Ruizhi-Deng/ME350-Project/Mechanical/350 Design Library/Standard Parts/Bearings/外螺纹轴承参数-淘宝店家.jpg

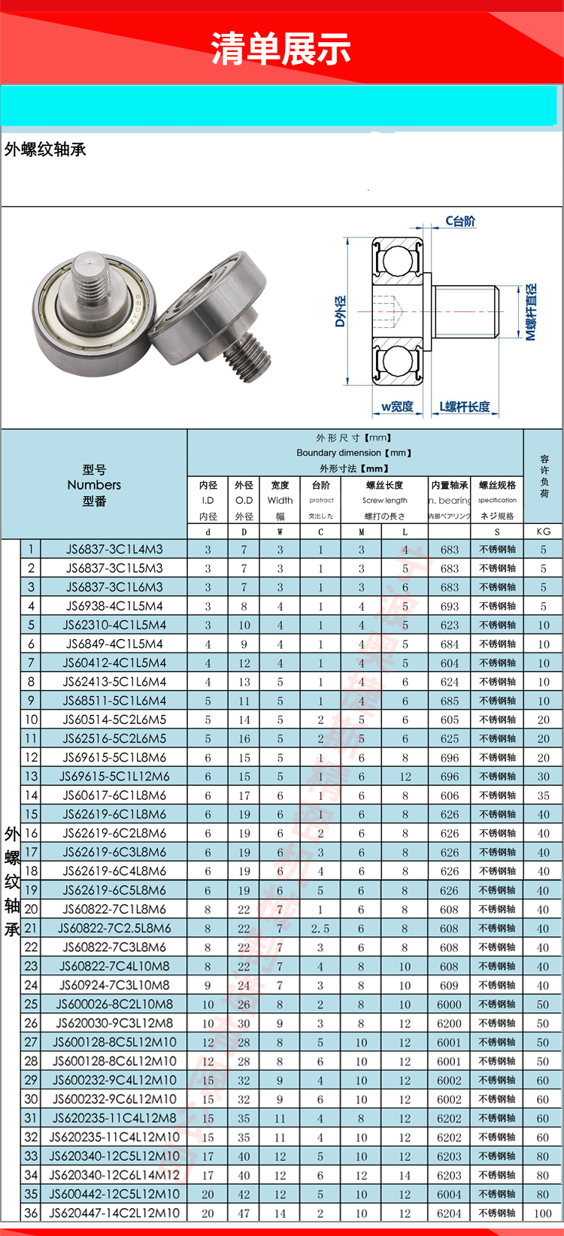
Mechanical/350 Design Library/Standard Parts/Bearings/外螺纹轴承参数-淘宝店家.jpg
