Ruizhi-Deng/ME350-Project/Mechanical/350 Design Library/Standard Parts/Nuts/Cold Pressing Nuts Parameter/071 072 073 Cold Pressing Nuts.jpg

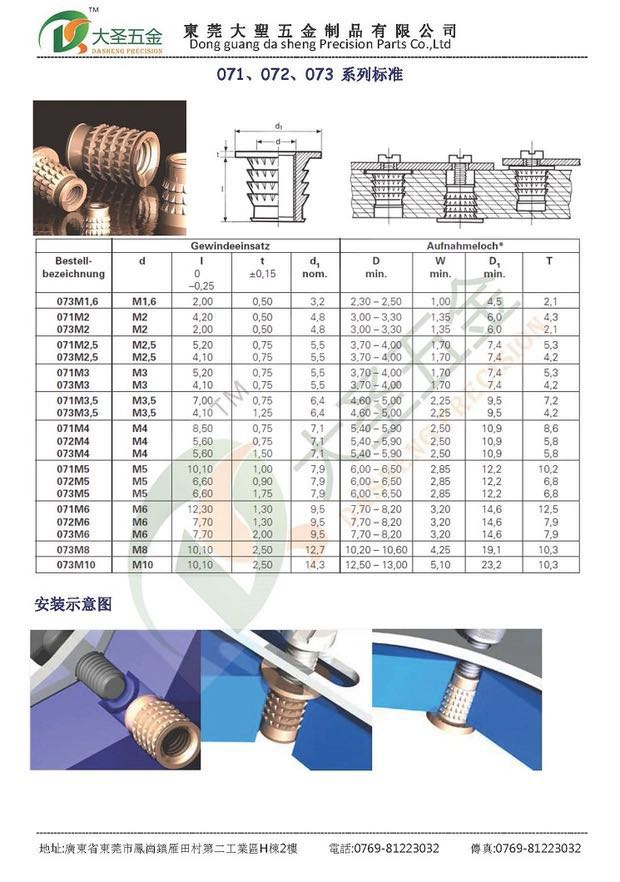
Mechanical/350 Design Library/Standard Parts/Nuts/Cold Pressing Nuts Parameter/071 072 073 Cold Pressing Nuts.jpg
