Ruizhi-Deng/ME350-Project/README.md

# ME350 Group 10 Project

This is the repository for the project of ME350 Group 10.
