Ruizhi-Deng/ME350-Project/Documents/dzfp_25362000000078212243_上海交通大学_20250804220630.pdf

# 电⼦发票（普通发票）

项目名称 | 规格型号 | 单 位 | 数 量 | 单 价 | 金 额 | 税率/征收率 | 税 额

发票号码：

开票日期：

购
买
方
信
息 | 统一社会信用代码/纳税人识别号：
名称： | 销
售
方
信
息 统一社会信用代码/纳税人识别号：

名称：

下载次数：1

合 | 计
价税合计（大写） | 肆拾柒圆柒角整 ¥ 47.70 （小写）

备 注

开票人：

国家税务总局 全 国 统一发 票 监 制章

江 西省税务局

¥47.23 | ¥0.47

张玉春

25362000000078212243

2025年08月04日

上海交通大学 | 江西善美邦纤维制品有限公司
1210000042500615X0 | 91360800332983584A
*专项化学用品*碳纤维管 12*10*1500mm | 支 | 47.2277227722772 | 47.23 | 1% | 0.47
