Ruizhi-Deng/ME350-Project/Documents/上海交通大学_4650637214420100312.pdf

销
售
方
信
息

统一社会信用代码/纳税人识别号：

购 名称：
买
方
信
息

统一社会信用代码/纳税人识别号：

名称：

25442000000448975464

2025年07月25日

上海交通大学

31010442500615X

广州市星翼电子科技有限公司

91440111598332340H

项目名称 | 规格型号 | 单 位 | 数 量 | 单 价 | 金 额 | 税率/征收率 | 税 | 额
*电子元件*烙铁 | T65智能电烙铁 | 套 | 1 154.194690265487 | 154.19 | 13% | 20.05
*电子元件*烙铁 | | | | | -10.62 | 13% | | -1.38
价税合计（大写） | 壹佰陆拾贰圆贰角肆分 （小写） ¥162.24
备 注 | 4650637214420100312
合 | 计

开票人：

吴国英

¥143.57 | ¥18.67
