Ruizhi-Deng/ME350-Project/Documents/dzfp_25362000000060566185_南昌县蒋巷欣兴塑料厂_20250623083155.pdf

# 电子发票（普通发票） 发票号码： 开票日期：

购
买
方
信
息

统一社会信用代码/纳税人识别号：

销
售
方
信
息

统一社会信用代码/纳税人识别号：

名称： | 名称：
项目名称 | 规格型号 | 单 位 | 数 量 | 单 价 | 金 额 | 税率/征收率 | 税 额
合 | 计
价税合计（大写） | 壹佰叁拾贰圆贰角整 ¥132.20 （小写）

备 注

开票人：

25362000000060566185

2025年06月22日

上海交通大学

1210000042500615X0

南昌县蒋巷欣兴塑料厂

## 92360121MABNWMTG8D

¥130.89 | ¥1.31

曾庆波

*塑料制品*塑料管PC透明
方管
10*10-10*15 | 件 | 6 21.8151815181518 | 130.89 | 1% | 1.31
