Ruizhi-Deng/ME350-Project/Documents/dzfp_25442000000369625213_惠州市煜盛电机科技有限公司_20250623150755.pdf

# 电子发票（普通发票） 发票号码： 开票日期：

购
买
方
信
息

统一社会信用代码/纳税人识别号：

销
售
方
信
息

统一社会信用代码/纳税人识别号：

名称： | 名称：
项目名称 | 规格型号 | 单 位 | 数 量 | 单 价 | 金 额 | 税率/征收率 | 税 额
合 | 计
价税合计（大写） | 捌拾柒圆贰角整 ¥87.20 （小写）

备 注

开票人：

25442000000369625213

2025年06月23日

上海交通大学

1210000042500615X0

惠州市煜盛电机科技有限公司

## 91441304MADAGW434E

¥86.34 | ¥0.86

钟云珠

*金属制品*马达 | JGY-370配支架 | 套 | 4 21.5841584158416 | 86.34 | 1% | 0.86
