Ruizhi-Deng/ME350-Project/Documents/dzfp_25952000000119703072.pdf

购
买
方
信
息

统一社会信用代码/纳税人识别号：

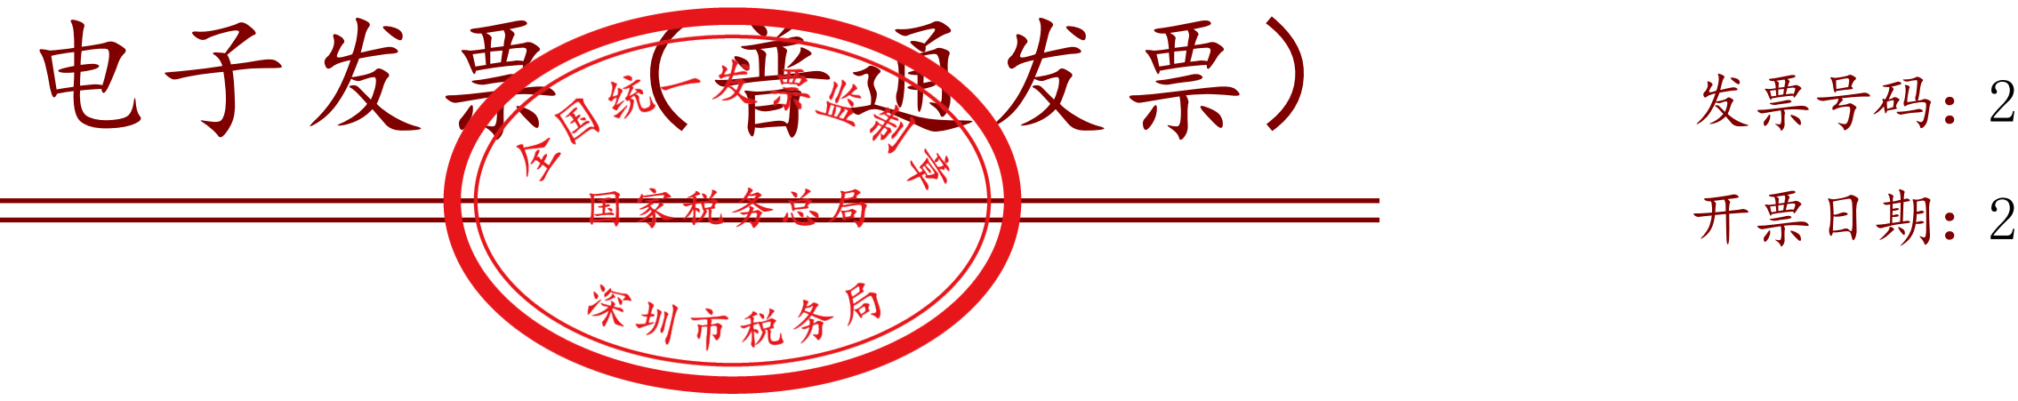
[picture p33: figure]
电子发票（普通发票）; 发票号码：; 开票日期：

销
售
方
信
息

统一社会信用代码/纳税人识别号：

名称： | 名称：
项目名称 | 规格型号 | 单 位 | 数 量 | 单 价 | 金 额 | 税率/征收率 | 税 额
合 | 计
价税合计（大写） | 贰拾叁圆捌角整 （小写） ¥23.80
备 注 | 订单：4385821140378100312 店铺：杰创森电子企业店

开票人：

下
载
次
数：1

25952000000119703072

2025年06月16日

上海交通大学

31010442500615X

深圳市杰创森科技有限公司

91440300MA5ECUMB6R

*电子元件*电子元器件 6mm加长 | 个 | 4 | 3.955 | 15.82 | 1% | 0.16
*齿轮*联轴器 | 6mm | 个 | 4 | 1.935 | 7.74 | 1% | 0.08
¥23.56 | ¥0.24

姜建平
