Ruizhi-Deng/ME350-Project/Documents/Render/corner.png

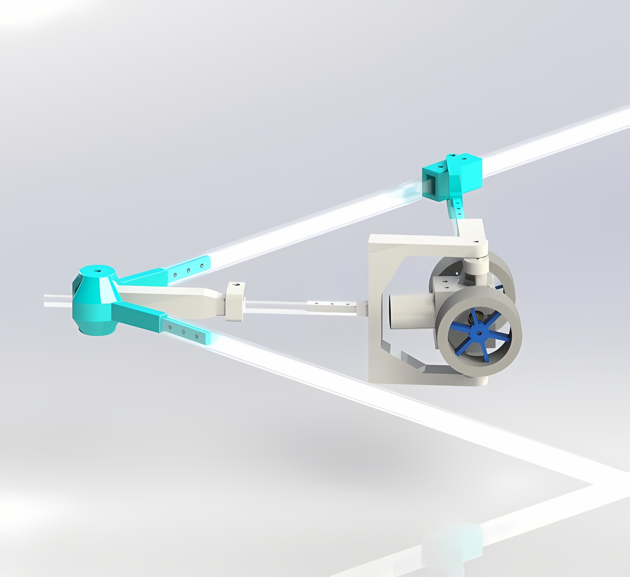
Documents/Render/corner.png
