Ruizhi-Deng/ME350-Project/Documents/Render/eds.JPG

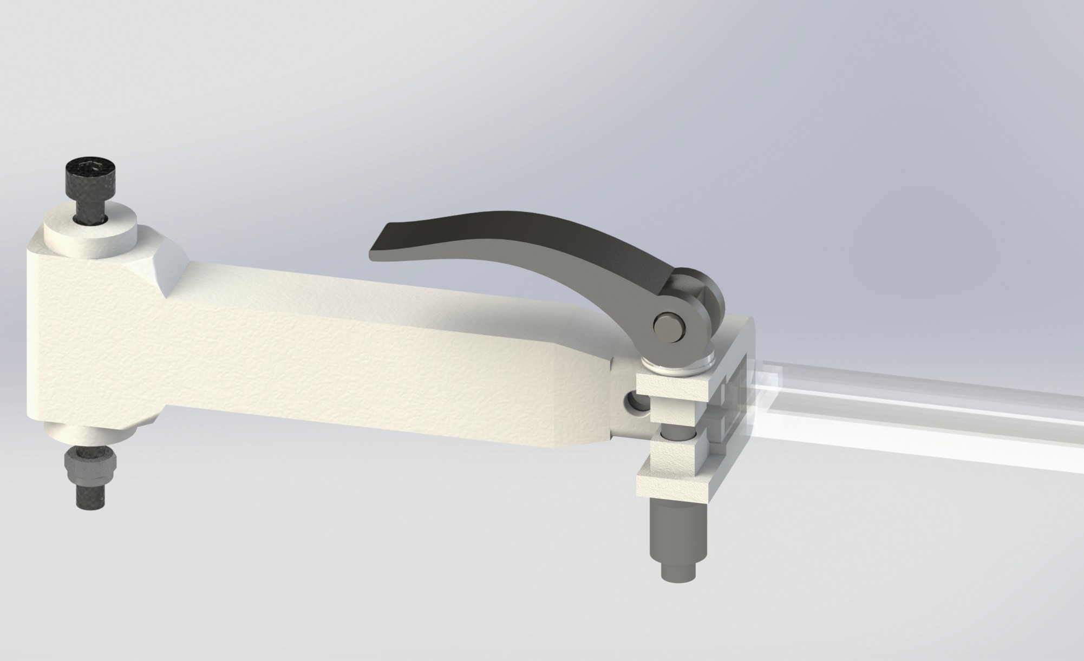
Documents/Render/eds.JPG
