Ruizhi-Deng/ME350-Project/Documents/Render/frame.JPG

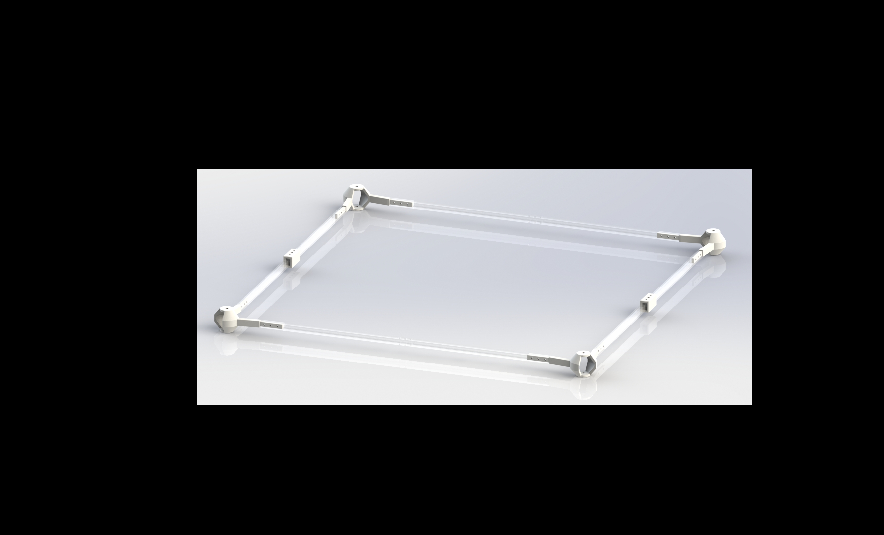
Documents/Render/frame.JPG
