Ruizhi-Deng/ME350-Project/Documents/Render/frame.png

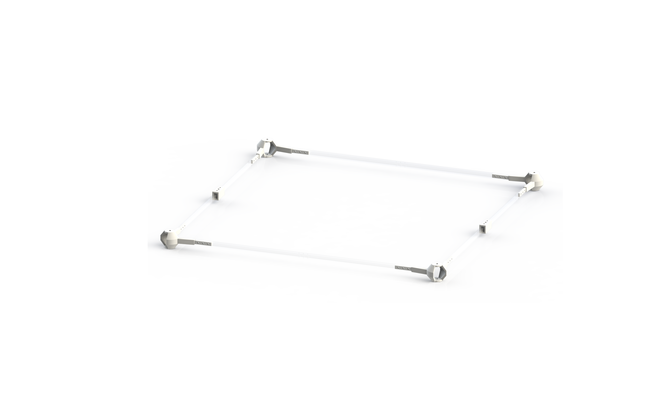
Documents/Render/frame.png
