Ruizhi-Deng/ME350-Project/Documents/Render/preview.png

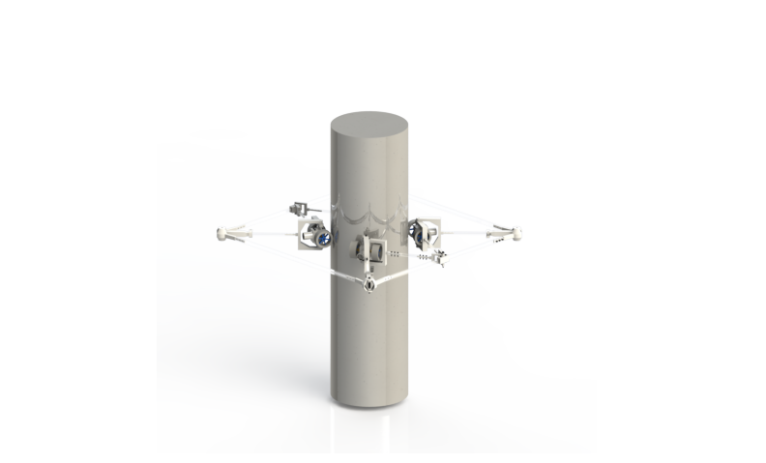
Documents/Render/preview.png
