Ruizhi-Deng/ME350-Project/Documents/Report/central base.png

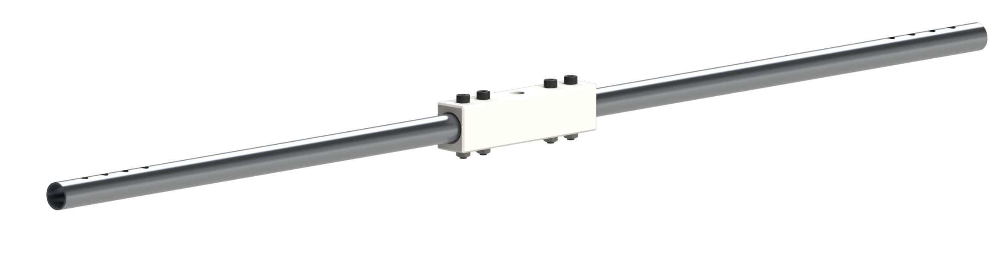
Documents/Report/central base.png
