Ruizhi-Deng/ME350-Project/Documents/Report/circuit.png

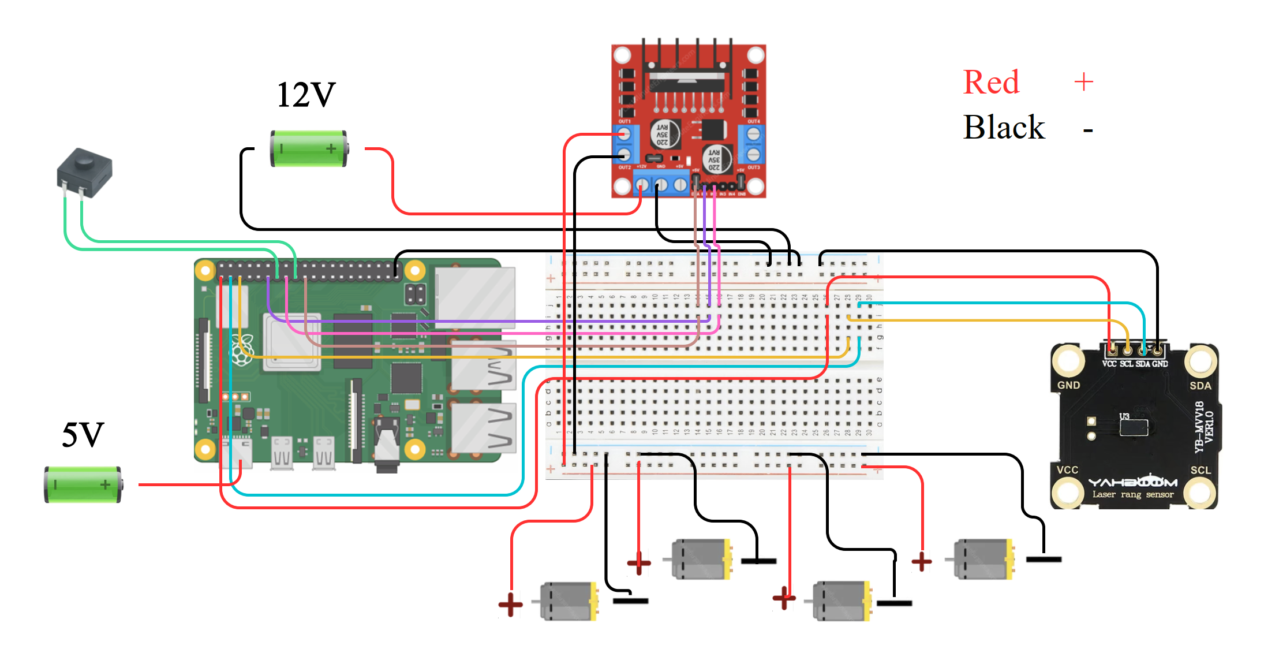
Documents/Report/circuit.png
