Ruizhi-Deng/ME350-Project/Documents/Report/clamp.png

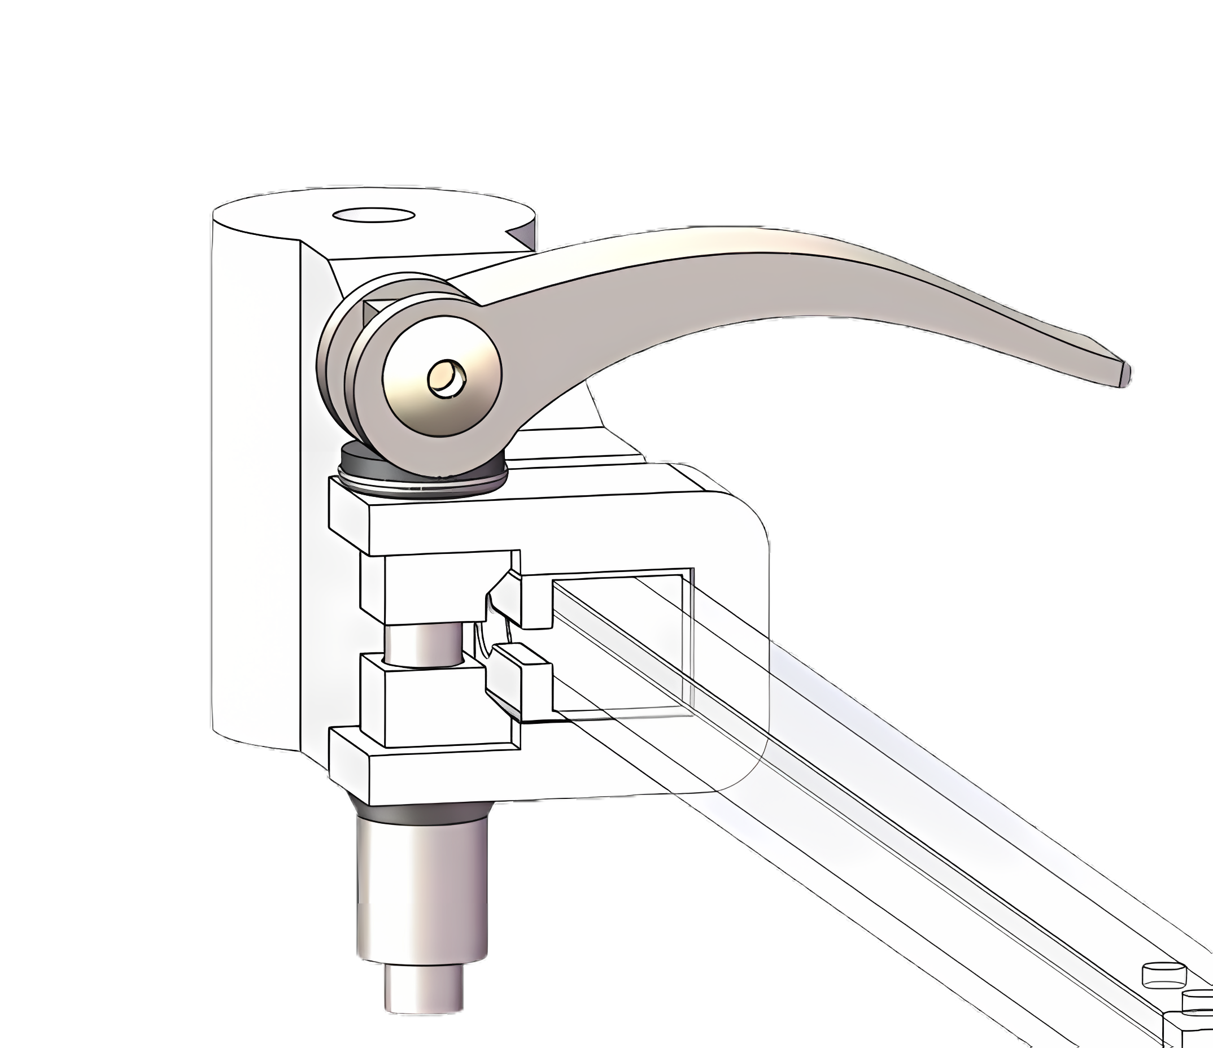
Documents/Report/clamp.png
