Ruizhi-Deng/ME350-Project/Documents/Report/corner connector set.png

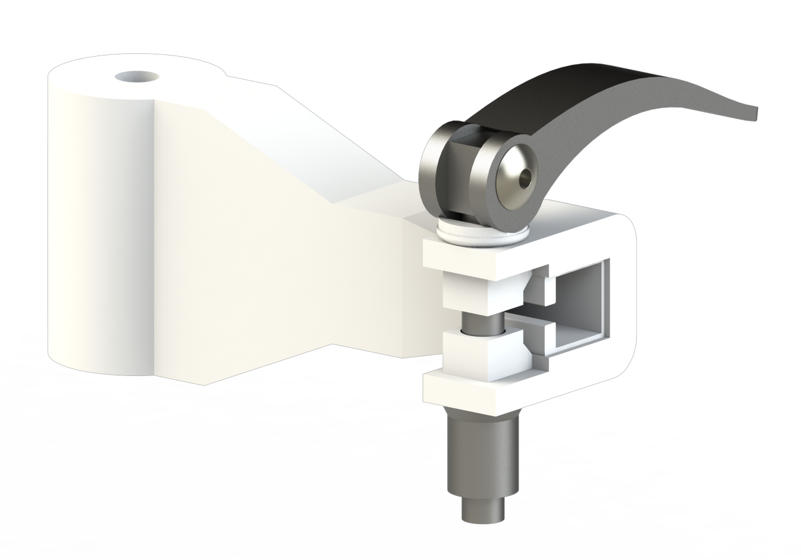
Documents/Report/corner connector set.png
