Ruizhi-Deng/ME350-Project/Documents/Report/corner.png

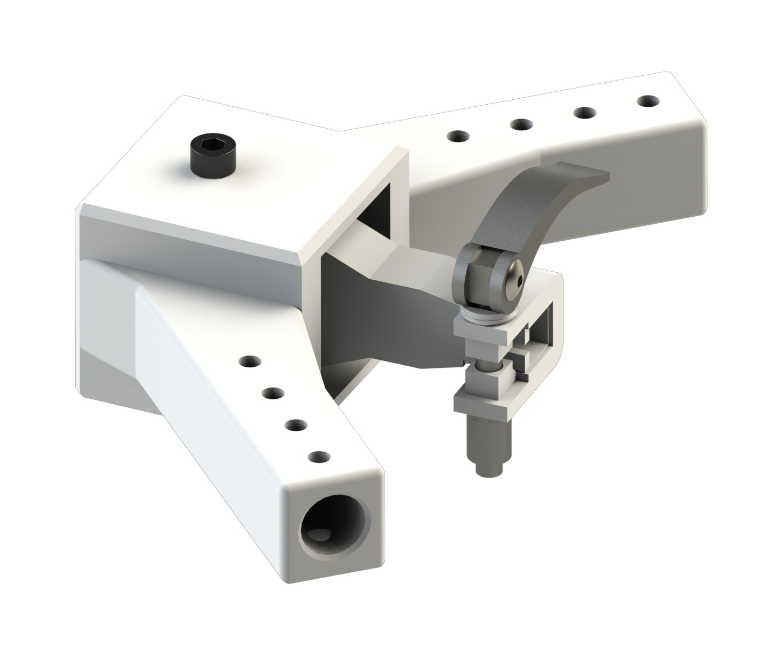
Documents/Report/corner.png
