Ruizhi-Deng/ME350-Project/Documents/Report/driving module motor 1.png

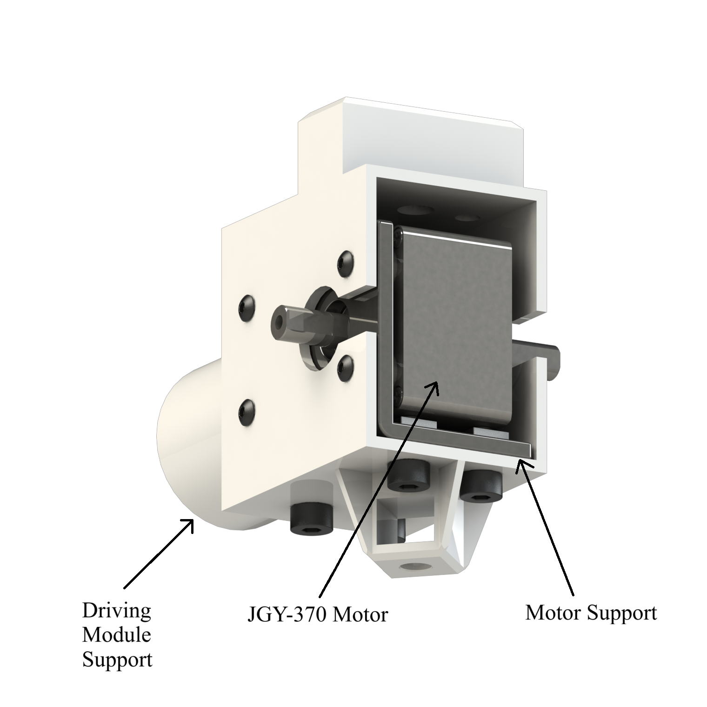
Documents/Report/driving module motor 1.png
