Ruizhi-Deng/ME350-Project/Documents/Report/driving module motor 2.png

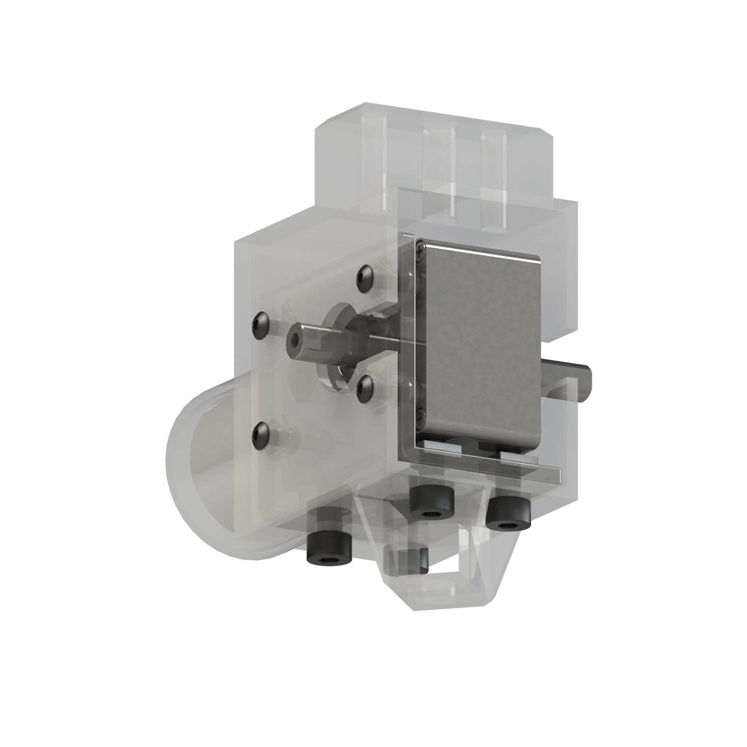
Documents/Report/driving module motor 2.png
