Ruizhi-Deng/ME350-Project/Documents/Report/driving module motor wheels 1.png

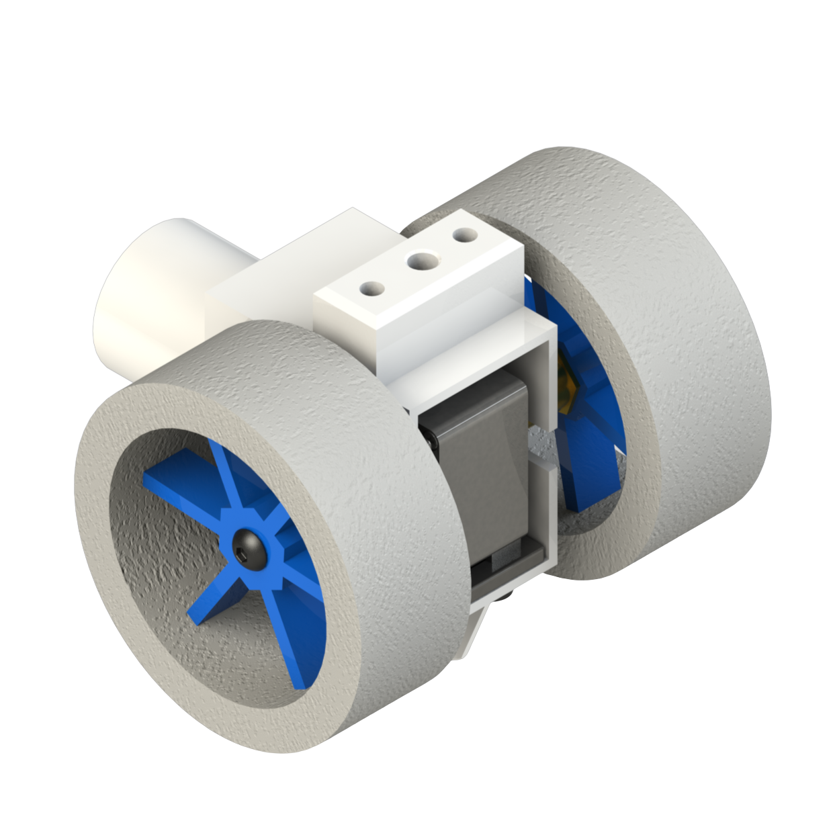
Documents/Report/driving module motor wheels 1.png
