Ruizhi-Deng/ME350-Project/Documents/Report/driving module total inner.png

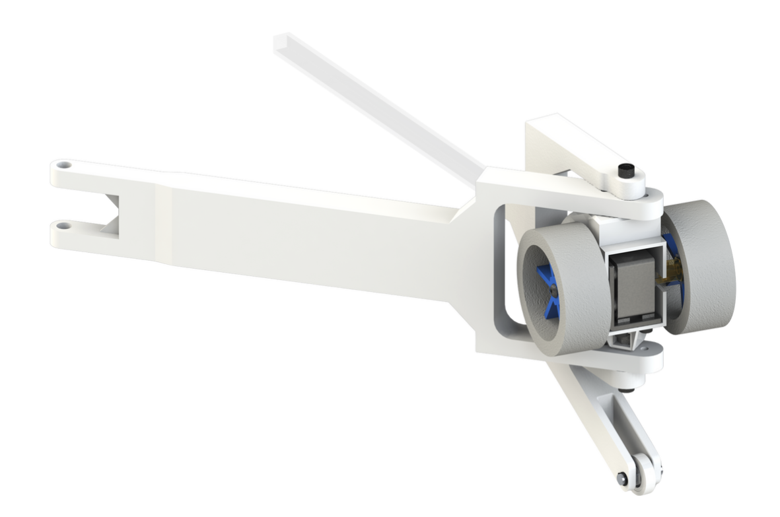
Documents/Report/driving module total inner.png
