Ruizhi-Deng/ME350-Project/Documents/Report/driving module total outer.png

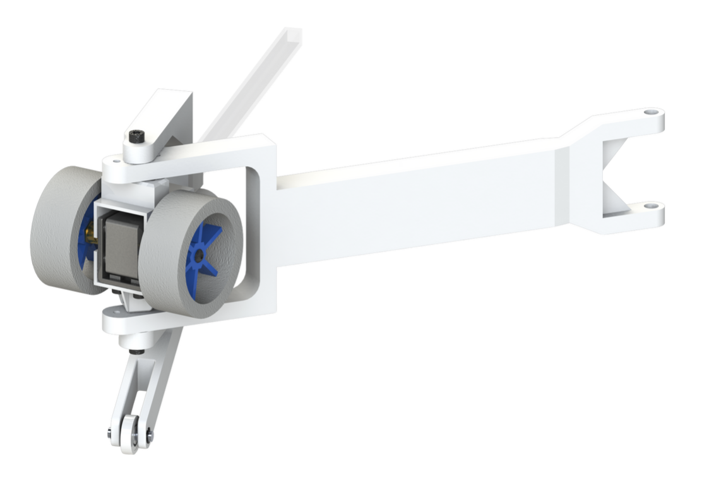
Documents/Report/driving module total outer.png
