Ruizhi-Deng/ME350-Project/Documents/Report/motor.png

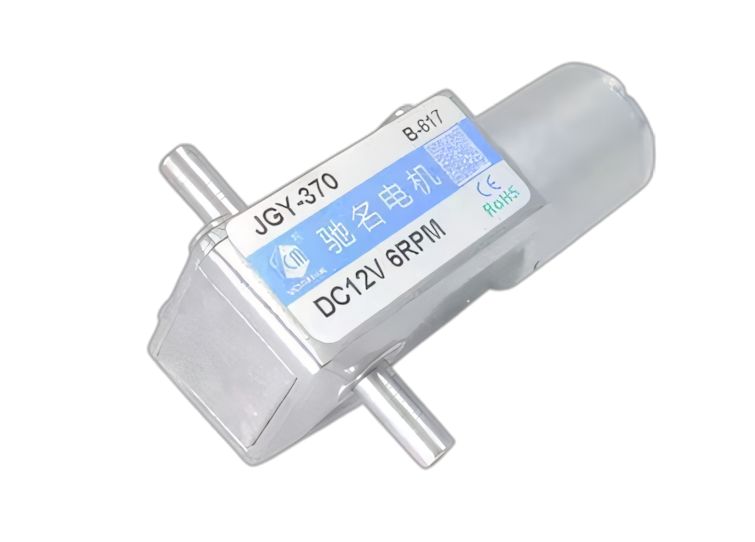
Documents/Report/motor.png
