Ruizhi-Deng/ME350-Project/Documents/Report/outer clamp front view.png

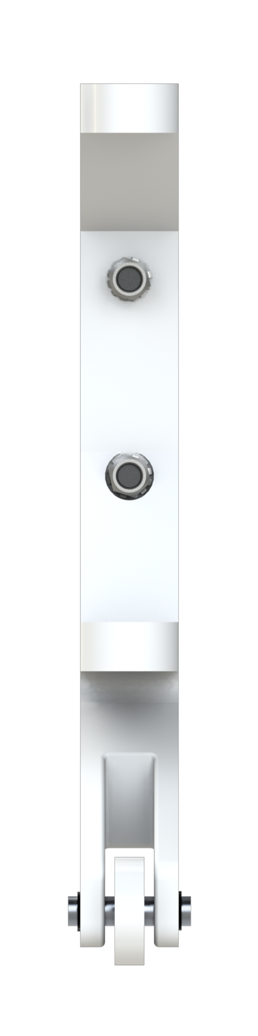
Documents/Report/outer clamp front view.png
