Ruizhi-Deng/ME350-Project/Documents/Report/outer clamp side view.png

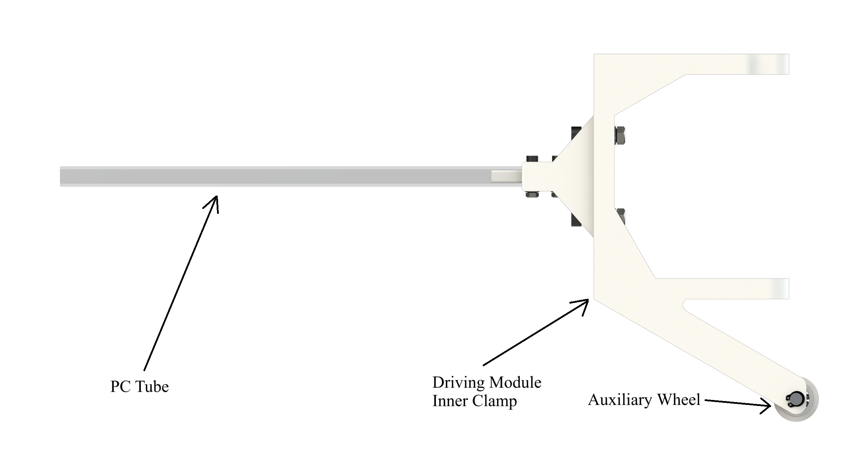
Documents/Report/outer clamp side view.png
