Ruizhi-Deng/ME350-Project/Documents/Report/total view 300.png

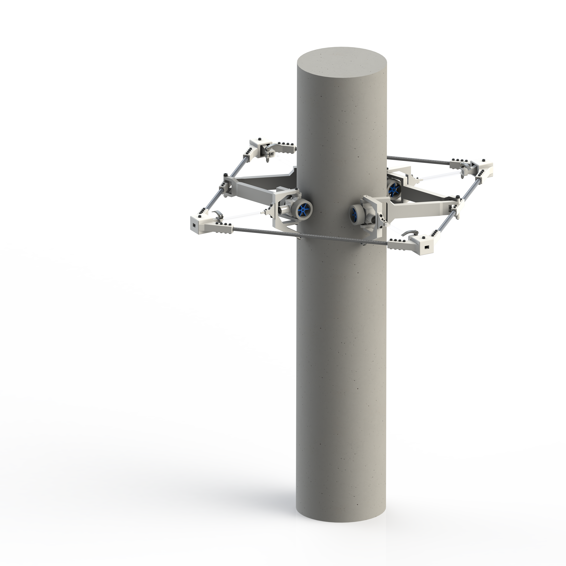
Documents/Report/total view 300.png
