Ruizhi-Deng/ME350-Project/Documents/Report/total view cropped small.png

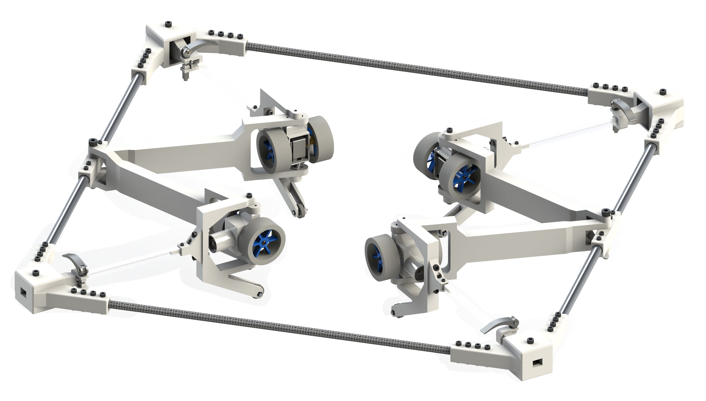
Documents/Report/total view cropped small.png
