Ruizhi-Deng/ME350-Project/Documents/Report/上视图600.png

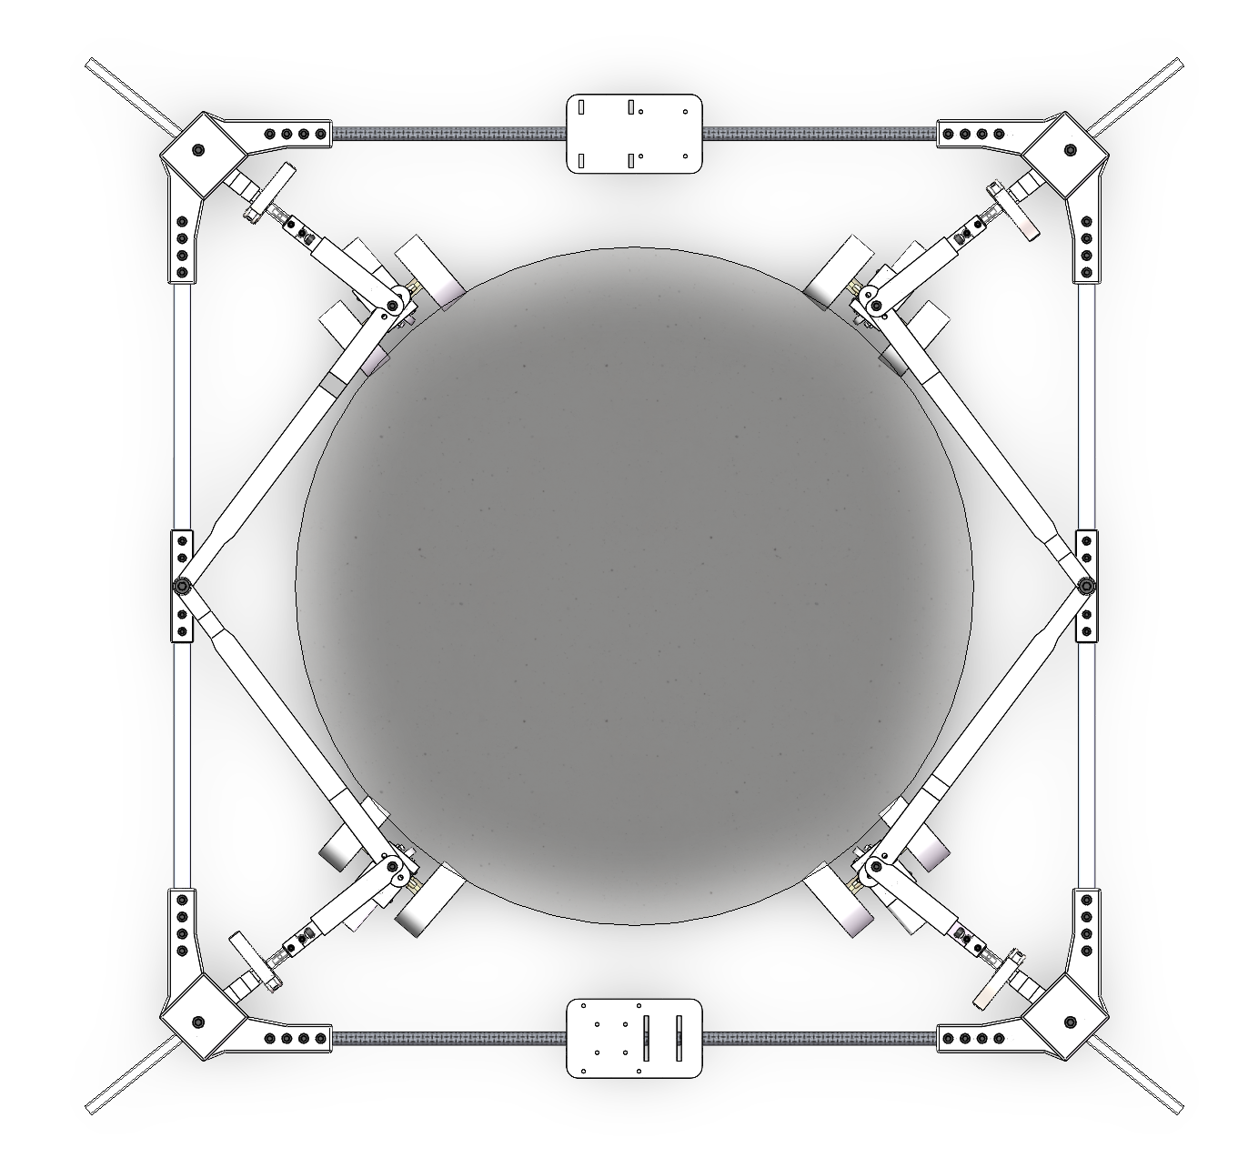
Documents/Report/上视图600.png
