Ruizhi-Deng/ME350-Project/Mechanical/350 Design Library/电机JGY 370/overview.jpg

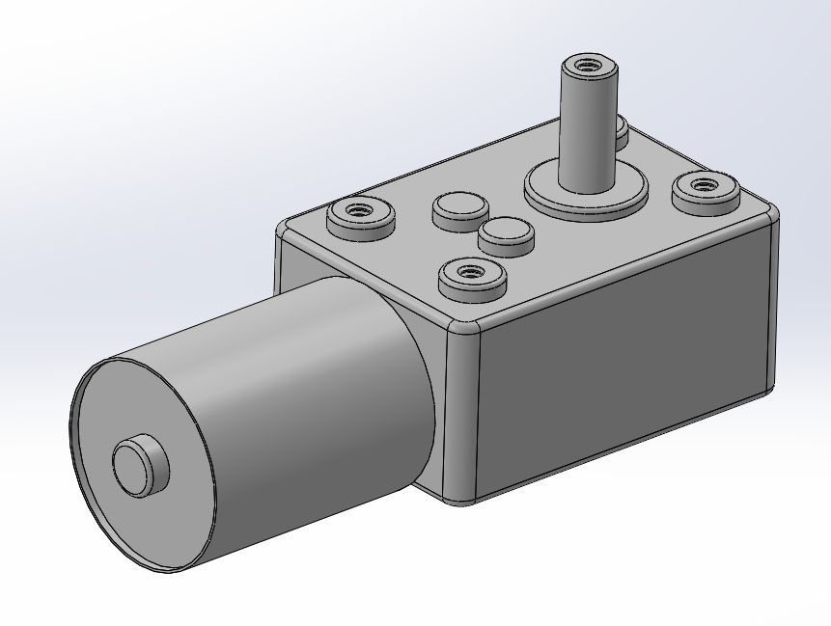
Mechanical/350 Design Library/电机JGY 370/overview.jpg
