Ruizhi-Deng/ME350-Project/Mechanical/350 Design Library/Standard Parts/Nuts/Cold Pressing Nuts Parameter/冷压螺母打印件孔尺寸.docx

001/002冷压螺母：

M2：2.9

M2.5：3.4

M3：3.9

M4：6.1

M5：6.7

M6：8.4

M8：10.8

0006冷压螺母：

M2：3.4

M2.5：4.3

M3：4.8

M4：6.3

M5：7.9

M6：9.8

M8：11.8

071/072/073冷压螺母：

M2：3.5

M2.5：4.2

M3：5.2

M4：6.1

M5：6.7

M6：8.4

M8：10.8

膨胀螺母：

M3：4.0放松效果强/嵌入难，4.1放松效果较强/嵌入简单

M4：5.6放松效果强/嵌入难，5.7放松效果较强/嵌入简单

M5：6.4放松效果强/嵌入难，6.5放松效果较强/嵌入简单

M6：8.0放松效果强/嵌入难，8.1放松效果较强/嵌入简单
