Ruizhi-Deng/ME350-Project/Mechanical/350 Design Library/Standard Parts/Nuts/Cold Pressing Nuts Parameter/001 002 Cold Pressing NUts.jpg

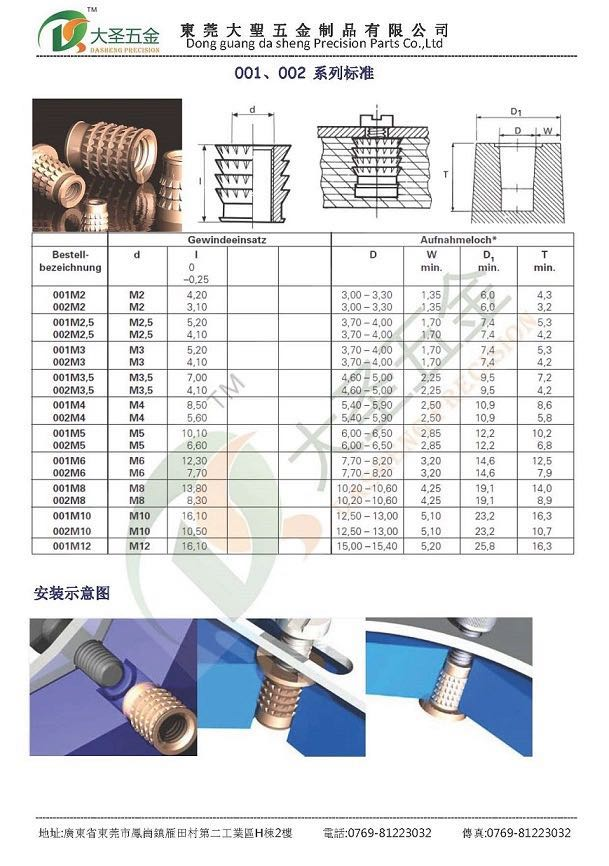
Mechanical/350 Design Library/Standard Parts/Nuts/Cold Pressing Nuts Parameter/001 002 Cold Pressing NUts.jpg
