Ruizhi-Deng/ME350-Project/Mechanical/350 Design Library/Standard Parts/Nuts/Cold Pressing Nuts Parameter/0006 Cold Pressing Nuts.jpg

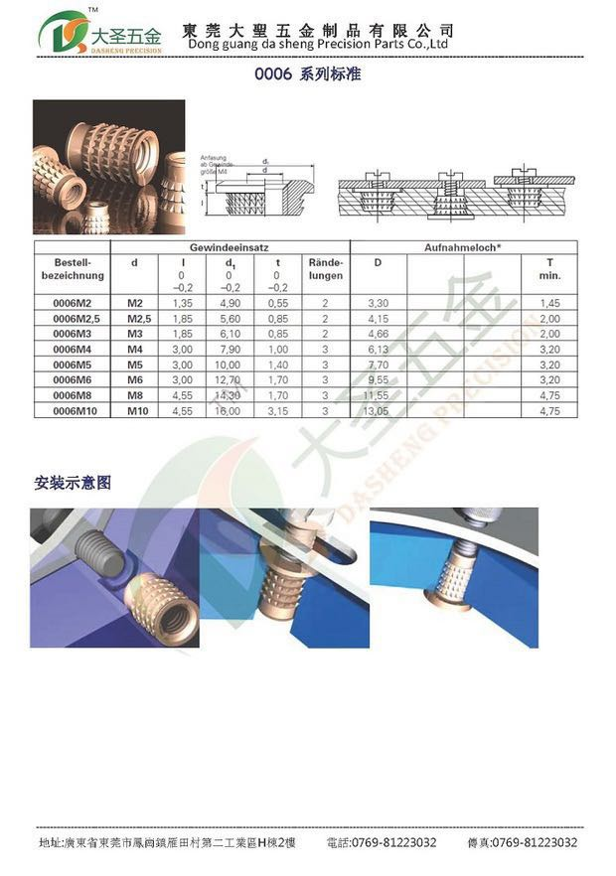
Mechanical/350 Design Library/Standard Parts/Nuts/Cold Pressing Nuts Parameter/0006 Cold Pressing Nuts.jpg
