Ruizhi-Deng/ME350-Project/Mechanical/350 Design Library/Standard Parts/Nuts/Cold Pressing Nuts Parameter/Slot Expension Nuts.jpg

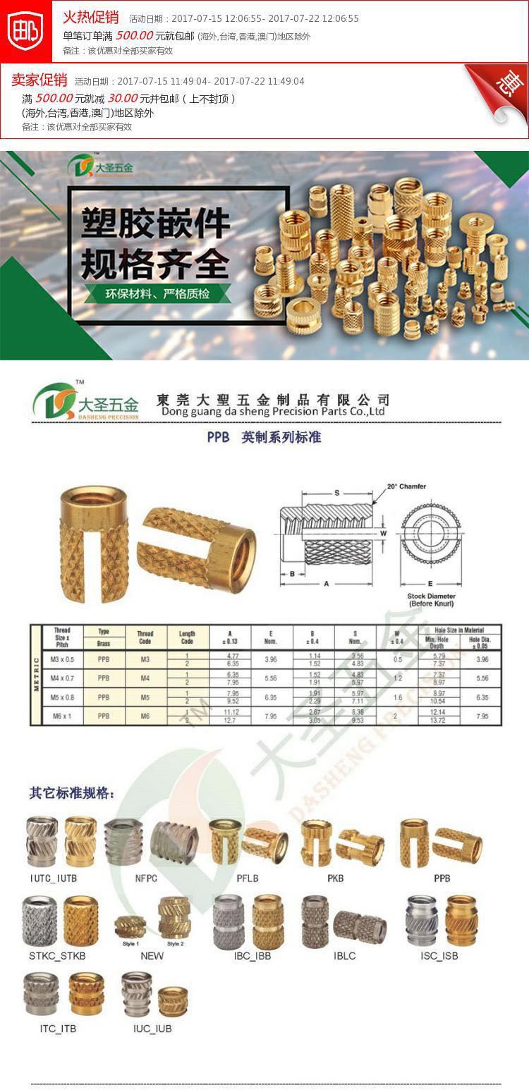
Mechanical/350 Design Library/Standard Parts/Nuts/Cold Pressing Nuts Parameter/Slot Expension Nuts.jpg
