Ruizhi-Deng/ME350-Project/Mechanical/350 Design Library/Standard Parts/Screws/螺丝参数/沉头螺丝参数.jpg

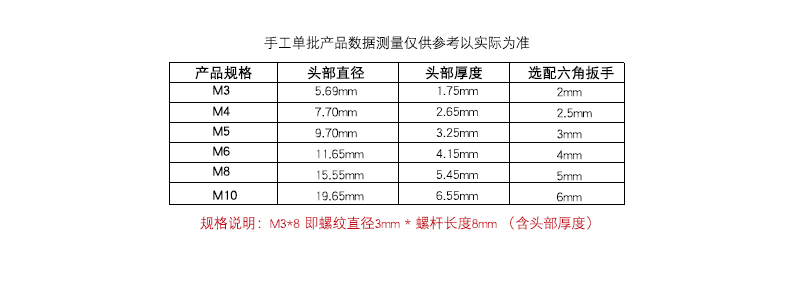
Mechanical/350 Design Library/Standard Parts/Screws/螺丝参数/沉头螺丝参数.jpg
