Ruizhi-Deng/ME350-Project/Mechanical/350 Design Library/Standard Parts/Screws/螺丝参数/英制塞打螺丝.jpg

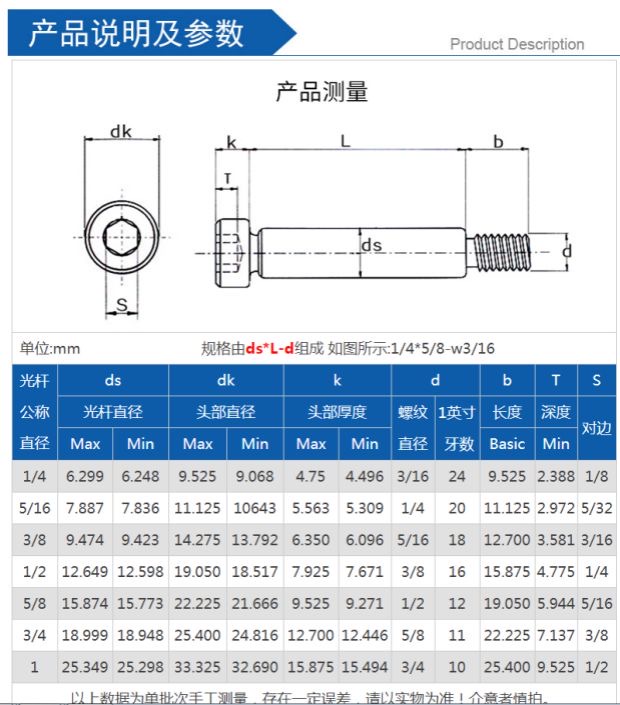
Mechanical/350 Design Library/Standard Parts/Screws/螺丝参数/英制塞打螺丝.jpg
