Ruizhi-Deng/ME350-Project/Mechanical/350 Design Library/Standard Parts/Springs/CFS25.png

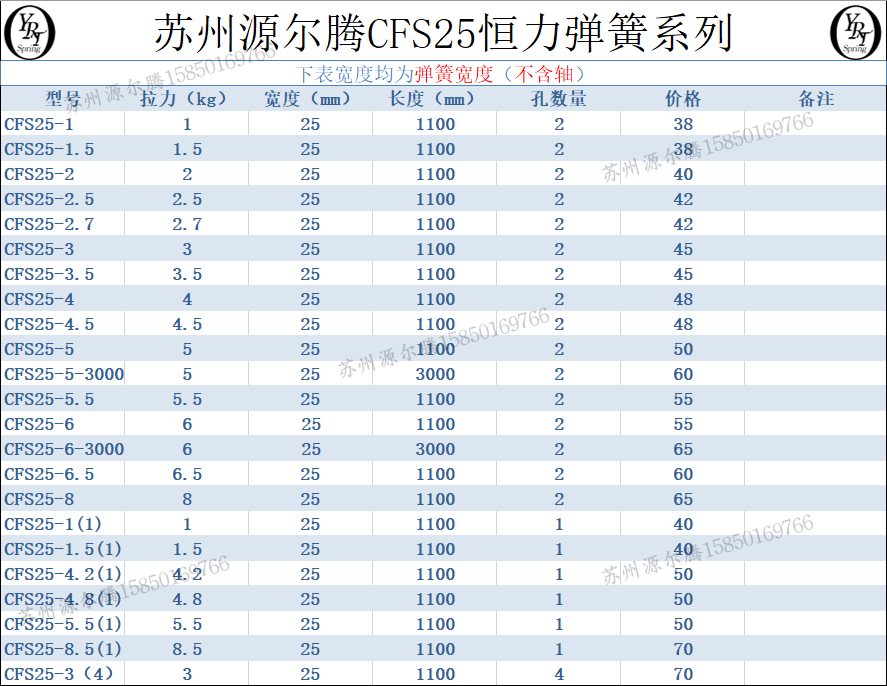
Mechanical/350 Design Library/Standard Parts/Springs/CFS25.png
