Ruizhi-Deng/ME350-Project/Mechanical/350 Design Library/Standard Parts/Springs/CFS.png

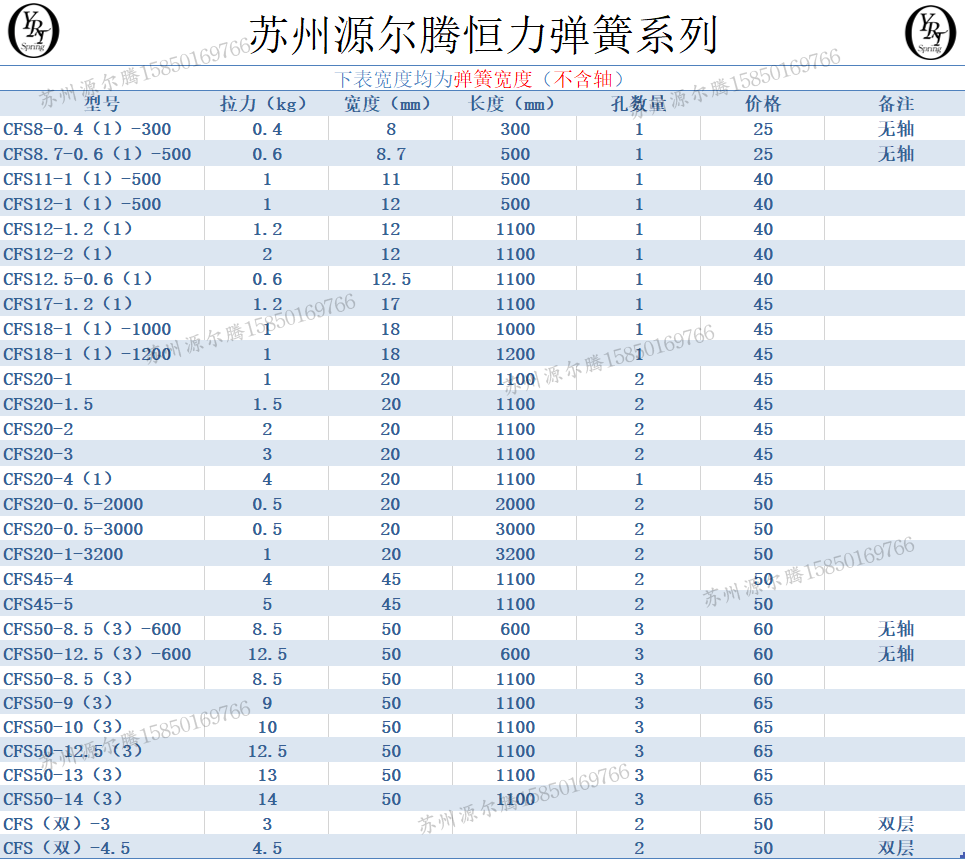
Mechanical/350 Design Library/Standard Parts/Springs/CFS.png
