Ruizhi-Deng/ME350-Project/Mechanical/350 Design Library/Standard Parts/铝方管规格图.jpg

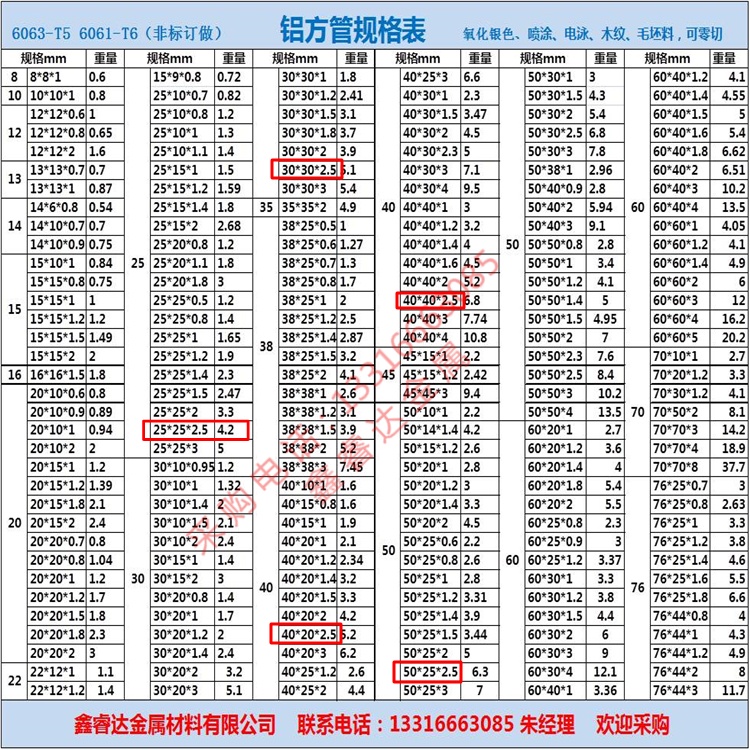
Mechanical/350 Design Library/Standard Parts/铝方管规格图.jpg
