Ruizhi-Deng/ME350-Project/Mechanical/Assembly/Assembly.SLDASM

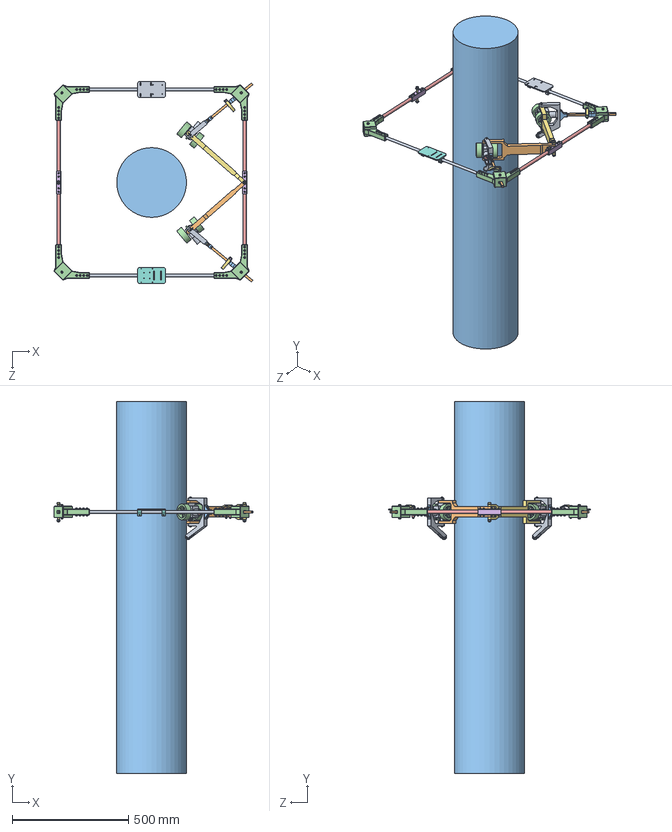
[picture p68: CAD file, 2025-08-08]
Mechanical/Assembly/Assembly.SLDASM
855.4 x 1600.0 x 870.0 mm
reference new
new frame corner connector base x 4
Al frame x 2
central connector base x 2
3-Cap Head Hexagon Screws-SJTUVEX x 70
3-K Shape Hexagon Nuts-SJTUVEX x 48
carbon fiber frame x 2
12mm to 15mm x 4
wheel x 4
六角联轴器6mm x 4
Double Output Axis JGY370 x 2
support x 2
single driver supportor x 2
3-Round Head Hexagon Screws-SJTUVEX x 12
3-Square Shape Nuts-SJTUVEX x 8
single driver connector outer x 2
PC_short_support x 2
frame corner connector x 2
frame corner connector pc clamp x 2
3-Nylon Hexagon Nuts-SJTUVEX x 10
nut x 2
shaft x 2
handle x 2
3-Aluminum Pop Rivet-SJTUVEX x 2
spacer x 2
central_inner-driver_inner connector
single driver connector outer casing x 2
Auxiliary wheel x 2
Auxiliary wheel shaft x 2
3-Shaft Circlip Rings-SJTUVEX x 4
central_outer-driver_inner connector
3-Plain Washers-SJTUVEX x 2
