Ruizhi-Deng/ME350-Project/Mechanical/Assembly/drive set central outer.SLDASM

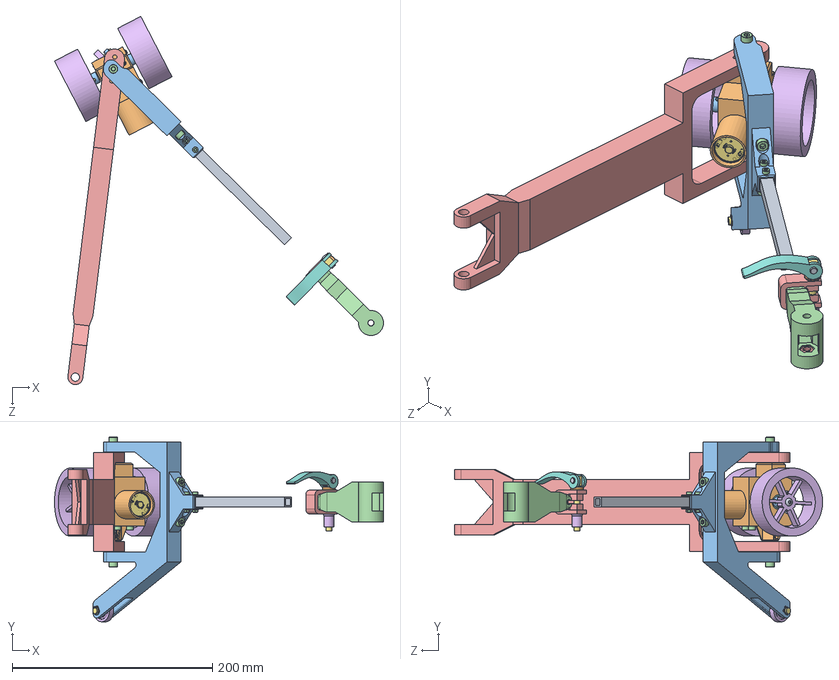
[picture p69: CAD file, 2025-08-08]
Mechanical/Assembly/drive set central outer.SLDASM
328.4 x 184.3 x 367.6 mm
3-Cap Head Hexagon Screws-SJTUVEX x 10
3-Nylon Hexagon Nuts-SJTUVEX x 4
wheel x 2
六角联轴器6mm x 2
Double Output Axis JGY370
support
single driver supportor
3-Round Head Hexagon Screws-SJTUVEX x 6
3-Square Shape Nuts-SJTUVEX x 4
single driver connector outer
PC_short_support
frame corner connector
frame corner connector pc clamp
nut
shaft
handle
3-Aluminum Pop Rivet-SJTUVEX
spacer
single driver connector outer casing
3-K Shape Hexagon Nuts-SJTUVEX x 4
central_outer-driver_inner connector
Auxiliary wheel
Auxiliary wheel shaft
3-Shaft Circlip Rings-SJTUVEX x 2
