Ruizhi-Deng/ME350-Project/Mechanical/drive set central outer.SLDASM

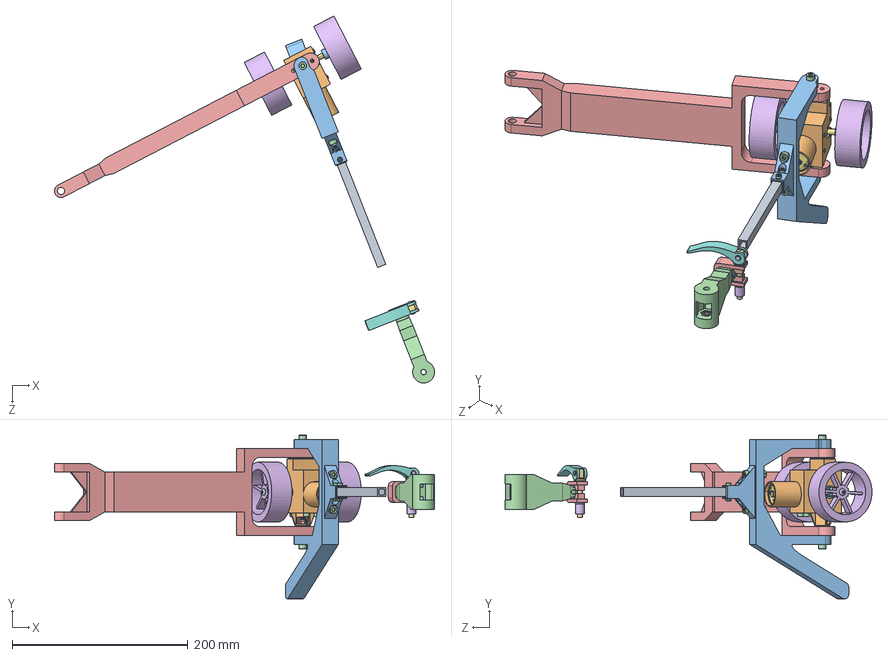
[picture p70: CAD file, 2025-07-29]
Mechanical/drive set central outer.SLDASM
432.8 x 186.4 x 417.9 mm
3-Cap Head Hexagon Screws-SJTUVEX x 10
3-Nylon Hexagon Nuts-SJTUVEX x 4
wheel x 2
六角联轴器6mm x 2
Double Output Axis JGY370
support
single driver supportor
3-Round Head Hexagon Screws-SJTUVEX x 6
3-Square Shape Nuts-SJTUVEX x 4
single driver connector outer
PC_short_support
frame corner connector
frame corner connector pc clamp
nut
shaft
handle
3-Aluminum Pop Rivet-SJTUVEX
spacer
single driver connector outer casing
3-K Shape Hexagon Nuts-SJTUVEX x 4
central_outer-driver_inner connector
