Ruizhi-Deng/ME350-Project/Mechanical/Assembly/drive set central inner.SLDASM

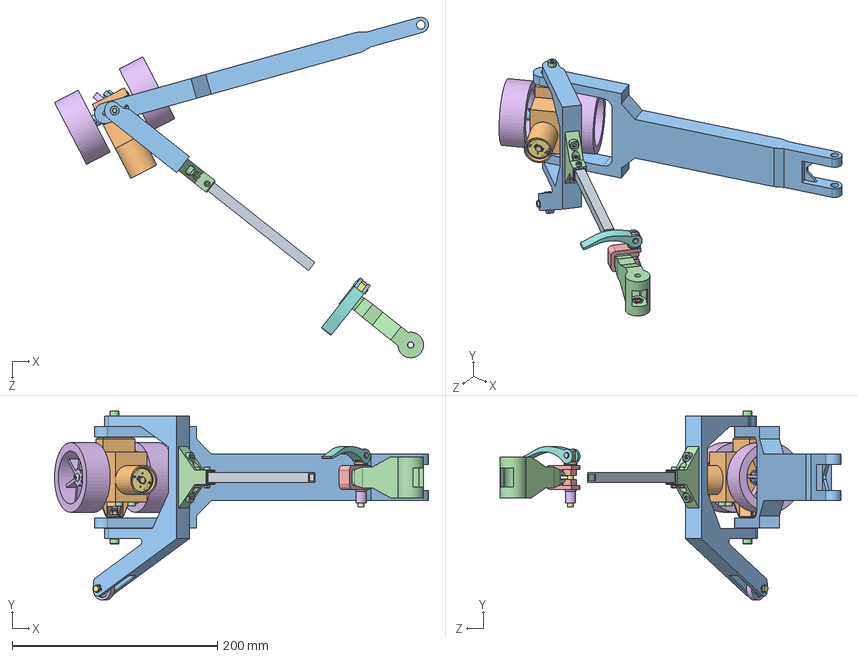
[picture p71: CAD file, 2025-08-08]
Mechanical/Assembly/drive set central inner.SLDASM
364.7 x 184.3 x 332.2 mm
wheel x 2
六角联轴器6mm x 2
Double Output Axis JGY370
support
single driver supportor
3-Round Head Hexagon Screws-SJTUVEX x 6
3-Cap Head Hexagon Screws-SJTUVEX x 10
3-Square Shape Nuts-SJTUVEX x 4
single driver connector outer
PC_short_support
frame corner connector
frame corner connector pc clamp
3-Nylon Hexagon Nuts-SJTUVEX x 4
nut
shaft
handle
3-Aluminum Pop Rivet-SJTUVEX
spacer
central_inner-driver_inner connector
single driver connector outer casing
3-K Shape Hexagon Nuts-SJTUVEX x 4
Auxiliary wheel
Auxiliary wheel shaft
3-Shaft Circlip Rings-SJTUVEX x 2
