Ruizhi-Deng/ME350-Project/Mechanical/Assembly/new frame.SLDASM

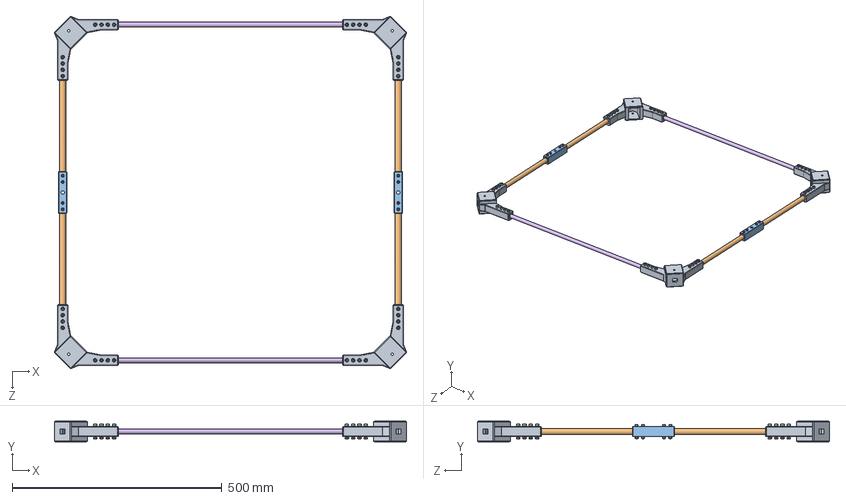
[picture p72: CAD file, 2025-08-03]
Mechanical/Assembly/new frame.SLDASM
839.1 x 50.0 x 839.1 mm
new frame corner connector base x 4
Al frame x 2
central connector base x 2
3-Cap Head Hexagon Screws-SJTUVEX x 40
3-K Shape Hexagon Nuts-SJTUVEX x 40
carbon fiber frame x 2
12mm to 15mm x 4
