Ruizhi-Deng/ME350-Project/Mechanical/Assembly/single_driver.SLDASM

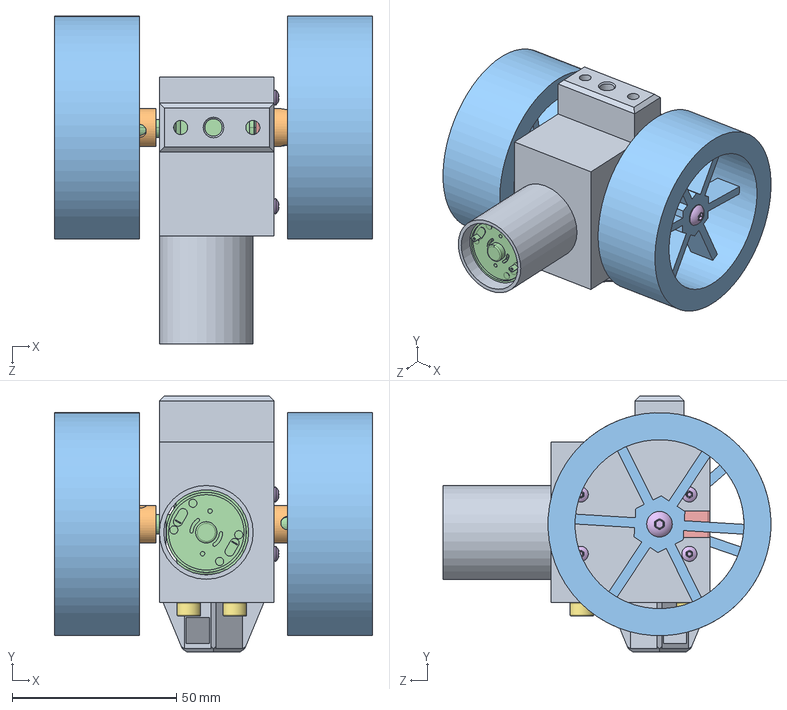
[picture p73: CAD file, 2025-08-03]
Mechanical/Assembly/single_driver.SLDASM
97.0 x 78.0 x 100.0 mm
wheel x 2
六角联轴器6mm x 2
Double Output Axis JGY370
support
single driver supportor
3-Round Head Hexagon Screws-SJTUVEX x 6
3-Cap Head Hexagon Screws-SJTUVEX x 4
3-Square Shape Nuts-SJTUVEX x 4
