Ruizhi-Deng/ME350-Project/Mechanical/Assembly/frame corner connector.SLDASM

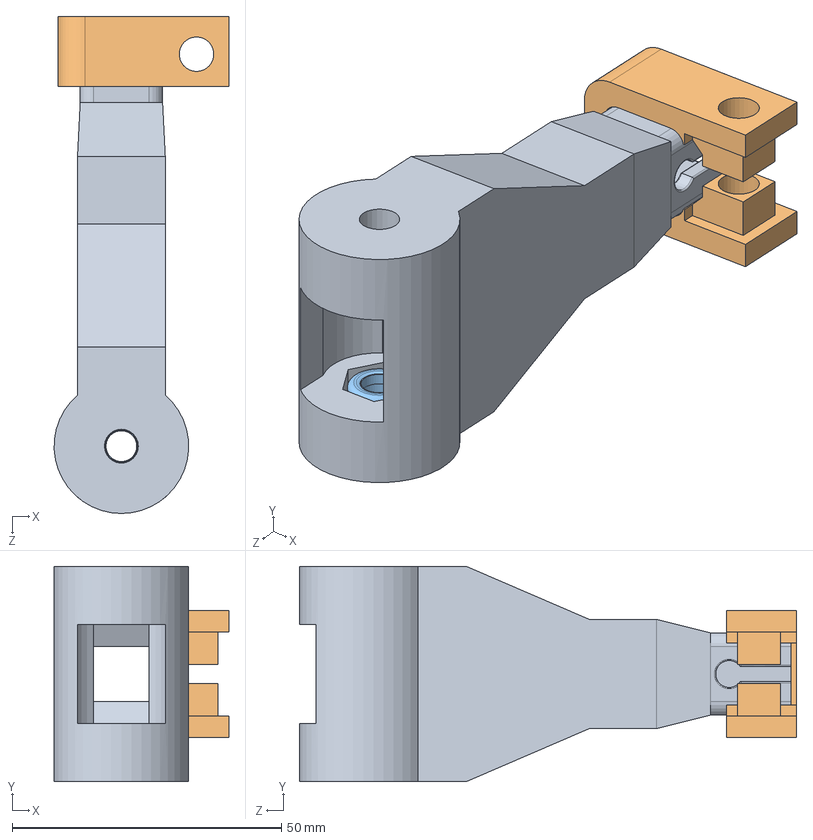
[picture p74: CAD file, 2025-08-03]
Mechanical/Assembly/frame corner connector.SLDASM
32.4 x 40.0 x 92.3 mm
frame corner connector
frame corner connector pc clamp
3-Nylon Hexagon Nuts-SJTUVEX x 2
