Ruizhi-Deng/ME350-Project/Mechanical/Assembly/frame.SLDASM

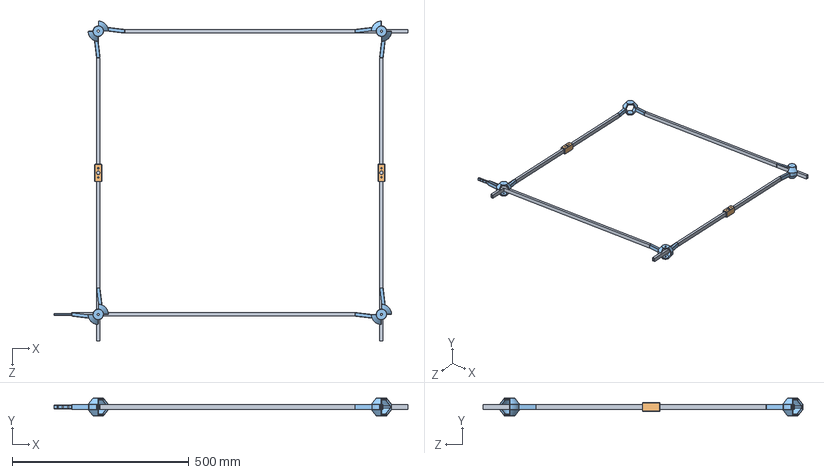
[picture p75: CAD file, 2025-07-15]
Mechanical/Assembly/frame.SLDASM
1000.0 x 50.0 x 903.7 mm
central connector base x 2
PC_frame x 4
frame corner connector base x 4
