Ruizhi-Deng/ME350-Project/Mechanical/Assembly/drive set corner.SLDASM

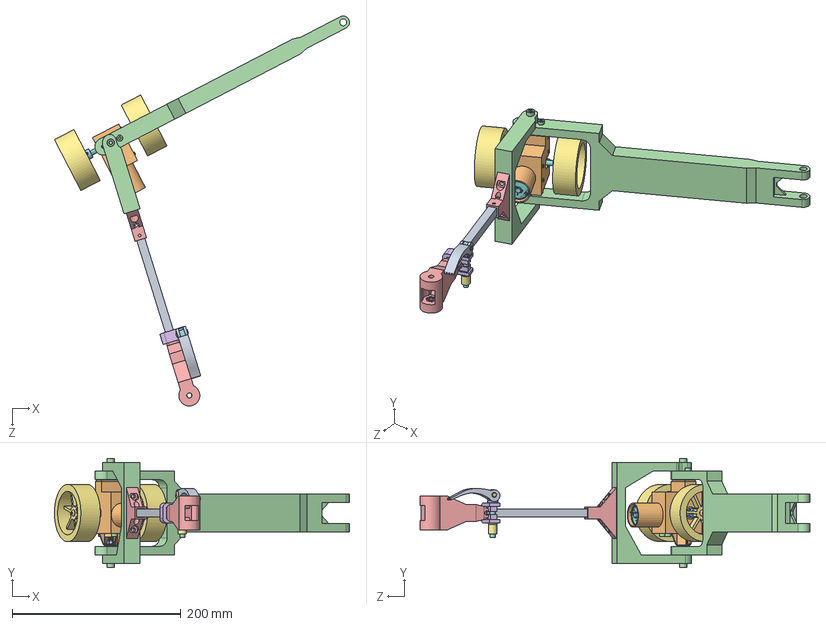
[picture p76: CAD file, 2025-07-15]
Mechanical/Assembly/drive set corner.SLDASM
349.4 x 129.5 x 461.8 mm
3-Cap Head Hexagon Screws-SJTUVEX x 7
3-K Shape Hexagon Nuts-SJTUVEX
3-Nylon Hexagon Nuts-SJTUVEX x 3
wheel x 2
六角联轴器6mm x 2
Double Output Axis JGY370
support
single driver supportor
3-Round Head Hexagon Screws-SJTUVEX x 6
3-Square Shape Nuts-SJTUVEX x 4
single driver connector outer
PC_short_support
frame corner connector
frame corner connector pc clamp
nut
shaft
handle
3-Aluminum Pop Rivet-SJTUVEX
spacer
central-driver_inner connector
single driver connector outer casing
