Ruizhi-Deng/ME350-Project/Mechanical/350 Design Library/Al frame.SLDPRT

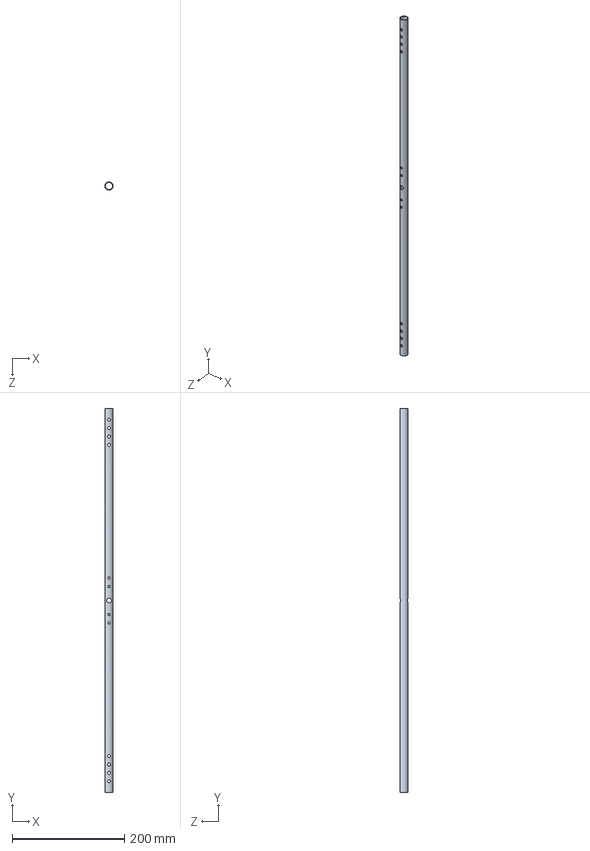
[picture p78: CAD file, 2025-08-08]
Mechanical/350 Design Library/Al frame.SLDPRT
15.0 x 685.0 x 15.0 mm
