Ruizhi-Deng/ME350-Project/Mechanical/350 Design Library/PC/PC_long_support.SLDPRT

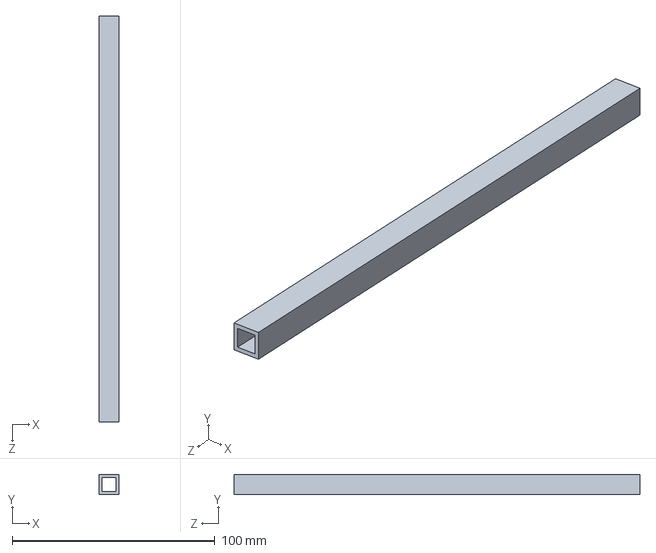
[picture p79: CAD file, 2025-07-15]
Mechanical/350 Design Library/PC/PC_long_support.SLDPRT
10.0 x 10.0 x 200.0 mm
