Ruizhi-Deng/ME350-Project/Mechanical/350 Design Library/树莓派 4 型号 B/Gigabit Ethernet Port, RPi4ModelB.SLDPRT

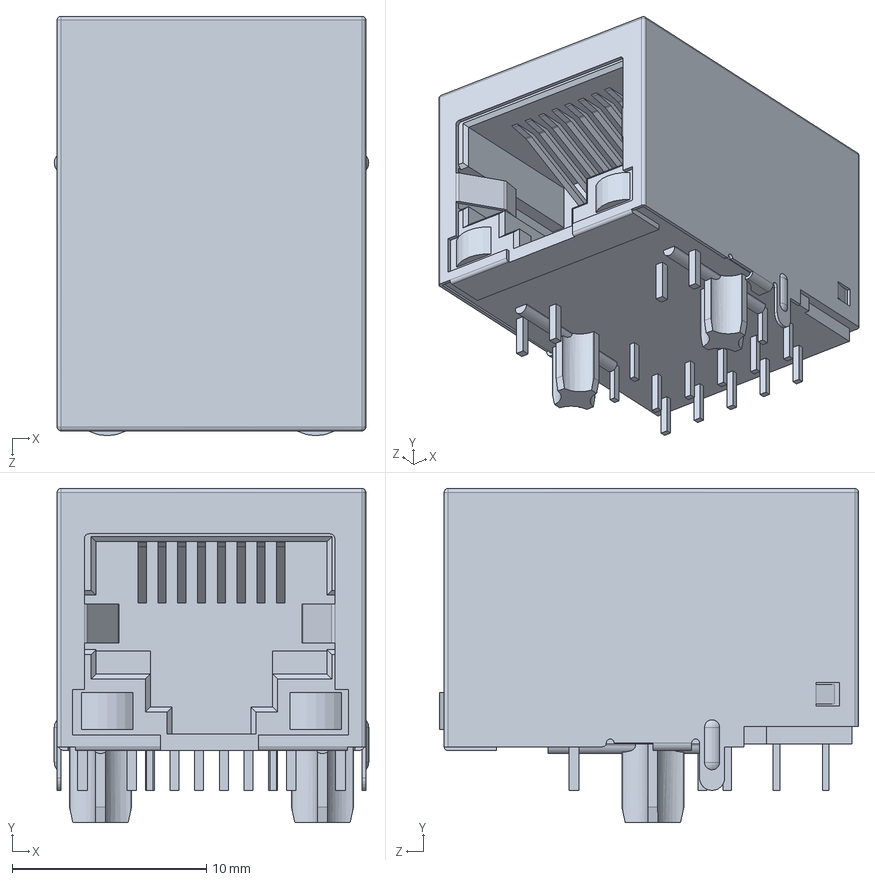
[picture p80: CAD file, 2025-07-08]
Mechanical/350 Design Library/树莓派 4 型号 B/Gigabit Ethernet Port, RPi4ModelB.SLDPRT
16.2 x 17.2 x 21.6 mm
