Ruizhi-Deng/ME350-Project/Mechanical/350 Design Library/电机JGY 370/support.SLDPRT

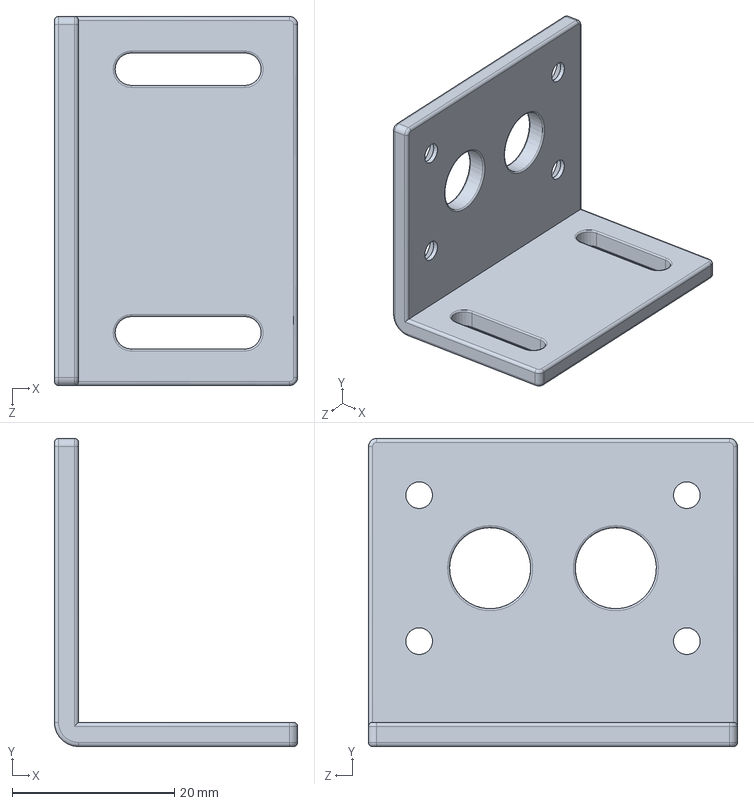
[picture p81: CAD file, 2025-07-08]
Mechanical/350 Design Library/电机JGY 370/support.SLDPRT
30.0 x 38.0 x 45.5 mm
