Ruizhi-Deng/ME350-Project/Mechanical/350 Design Library/胶轮/六角联轴器6mm.SLDPRT

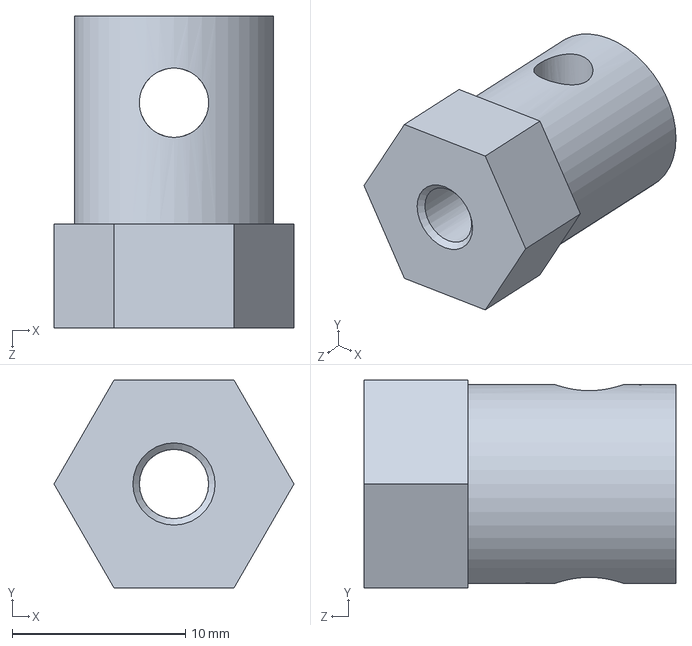
[picture p82: CAD file, 2025-08-03]
Mechanical/350 Design Library/胶轮/六角联轴器6mm.SLDPRT
13.9 x 12.0 x 18.0 mm
