Ruizhi-Deng/ME350-Project/Mechanical/Control box/control_board.SLDPRT

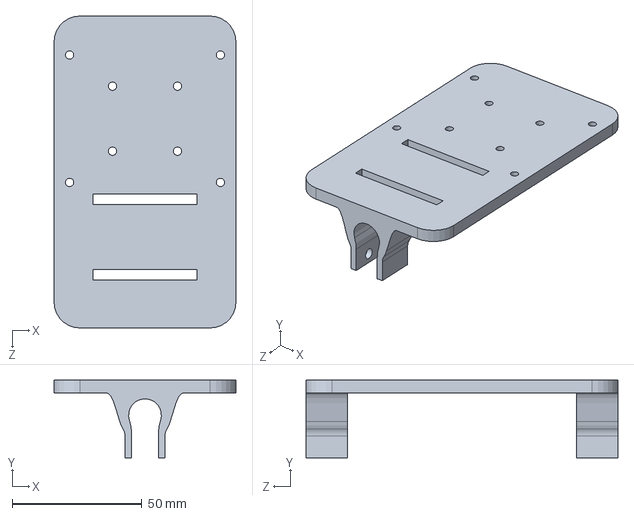
[picture p83: CAD file, 2025-07-22]
Mechanical/Control box/control_board.SLDPRT
70.0 x 29.9 x 120.0 mm
