Ruizhi-Deng/ME350-Project/Mechanical/Manufacture/v3/single driver connector outer_v3.STL

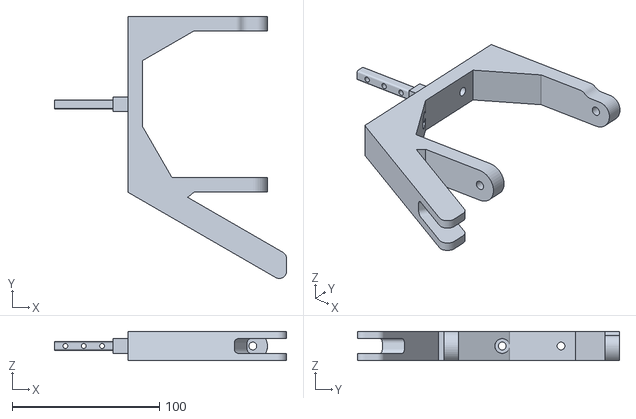
[picture p84: CAD file, 2025-07-21]
Mechanical/Manufacture/v3/single driver connector outer_v3.STL
158.0 x 178.2 x 20.0
