Ruizhi-Deng/ME350-Project/Mechanical/Parts/single driver supportor.SLDPRT

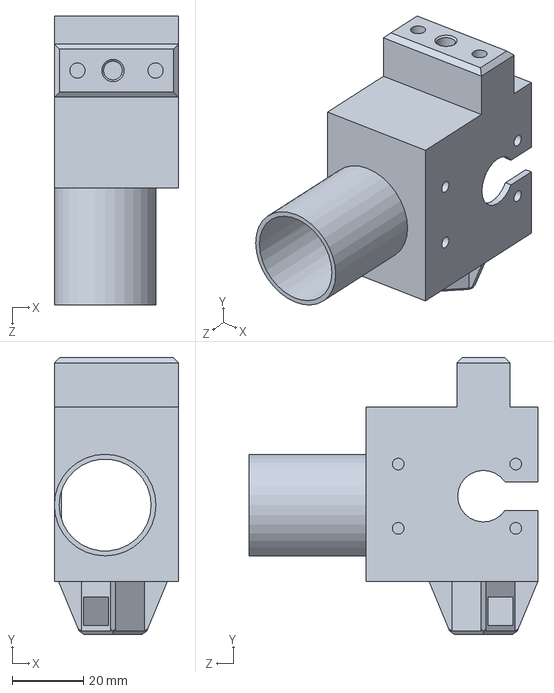
[picture p85: CAD file, 2025-08-03]
Mechanical/Parts/single driver supportor.SLDPRT
35.0 x 78.0 x 81.3 mm
