Ruizhi-Deng/ME350-Project/Mechanical/reference new.SLDPRT

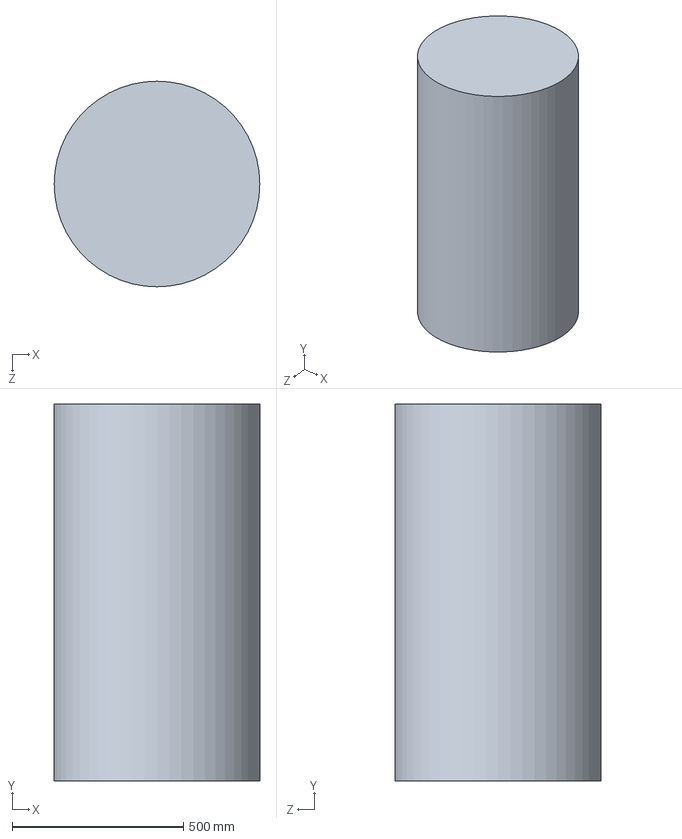
[picture p86: CAD file, 2025-08-03]
Mechanical/reference new.SLDPRT
600.0 x 1100.0 x 600.0 mm
