Ruizhi-Deng/ME350-Project/Mechanical/350 Design Library/Auxiliary wheel shaft.SLDPRT

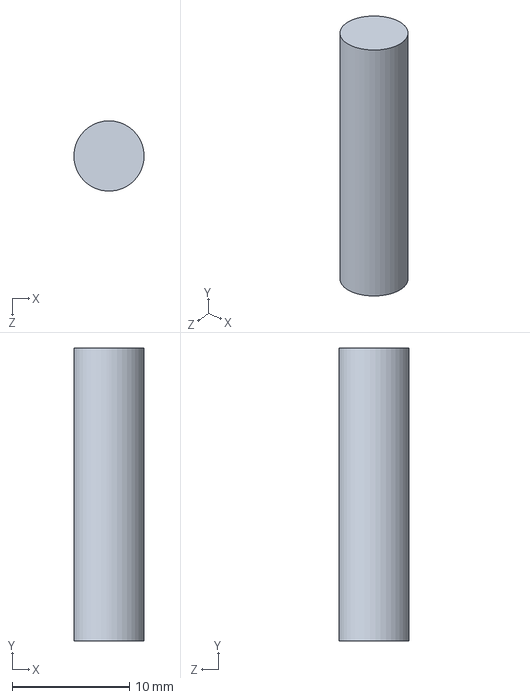
[picture p87: CAD file, 2025-07-29]
Mechanical/350 Design Library/Auxiliary wheel shaft.SLDPRT
6.00 x 25.0 x 6.00 mm
