Ruizhi-Deng/ME350-Project/Mechanical/350 Design Library/PC/PC_frame.SLDPRT

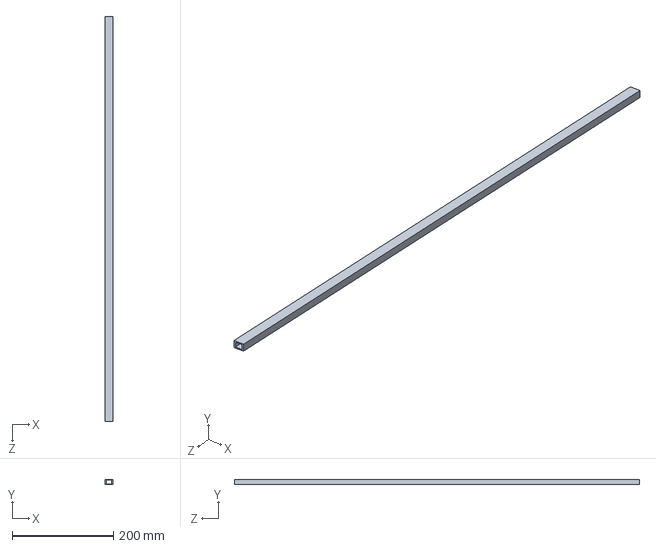
[picture p88: CAD file, 2025-07-15]
Mechanical/350 Design Library/PC/PC_frame.SLDPRT
15.0 x 10.0 x 800.0 mm
