Ruizhi-Deng/ME350-Project/Mechanical/350 Design Library/树莓派 4 型号 B/Display Connector, RPi4ModelB.SLDPRT

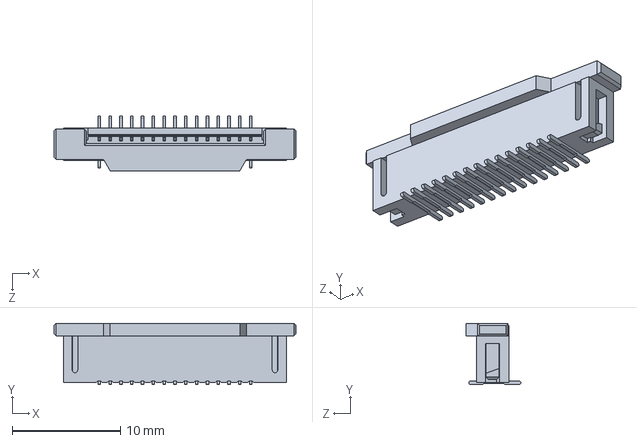
[picture p89: CAD file, 2025-07-08]
Mechanical/350 Design Library/树莓派 4 型号 B/Display Connector, RPi4ModelB.SLDPRT
22.4 x 5.68 x 5.07 mm
