Ruizhi-Deng/ME350-Project/Mechanical/350 Design Library/电机JGY 370/Double Output Axis JGY370.STEP

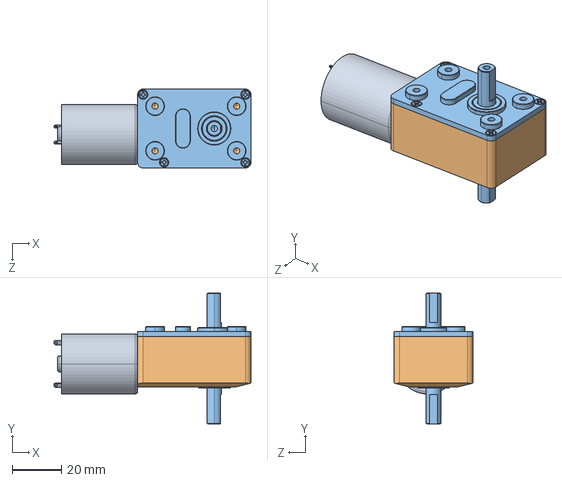
[picture p90: CAD file, 2025-06-20]
Mechanical/350 Design Library/电机JGY 370/Double Output Axis JGY370.STEP
79.9 x 53.0 x 32.0 mm
