Ruizhi-Deng/ME350-Project/Mechanical/350 Design Library/胶轮/wheel.SLDPRT

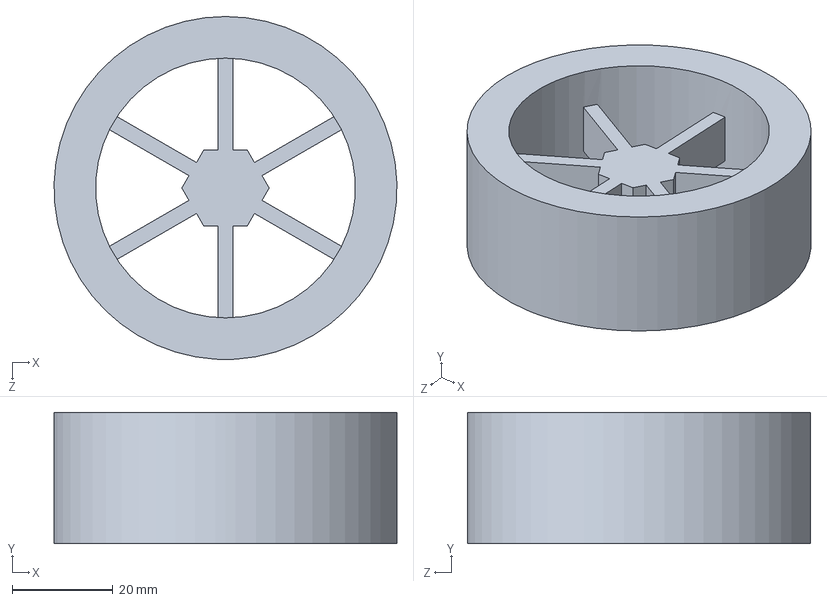
[picture p91: CAD file, 2025-06-20]
Mechanical/350 Design Library/胶轮/wheel.SLDPRT
68.0 x 26.0 x 68.0 mm
