Ruizhi-Deng/ME350-Project/Mechanical/Control box/power_board.SLDPRT

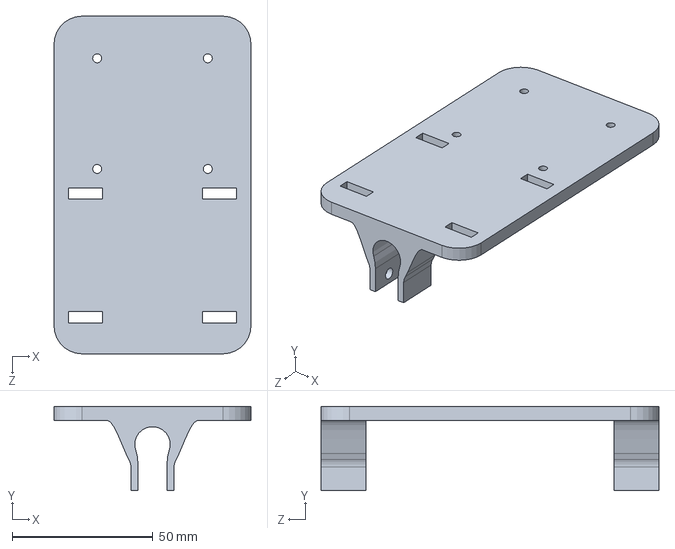
[picture p92: CAD file, 2025-07-21]
Mechanical/Control box/power_board.SLDPRT
70.0 x 29.9 x 120.0 mm
