Ruizhi-Deng/ME350-Project/Mechanical/Manufacture/v3/12mm to 15mm.STL

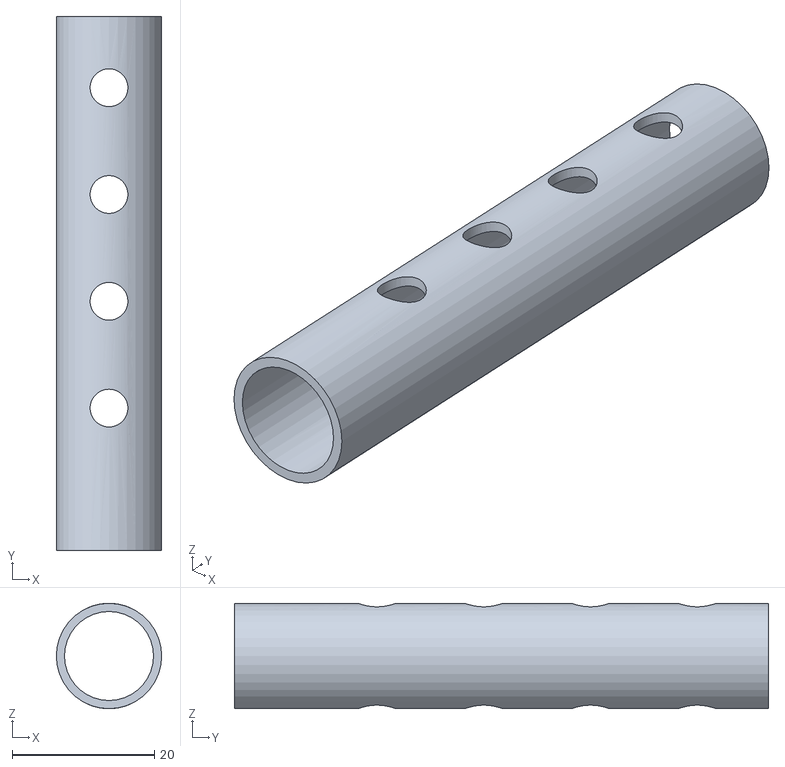
[picture p93: CAD file, 2025-07-15]
Mechanical/Manufacture/v3/12mm to 15mm.STL
14.8 x 75.0 x 14.8
