Ruizhi-Deng/ME350-Project/Mechanical/Parts/single driver connector outer casing.SLDPRT

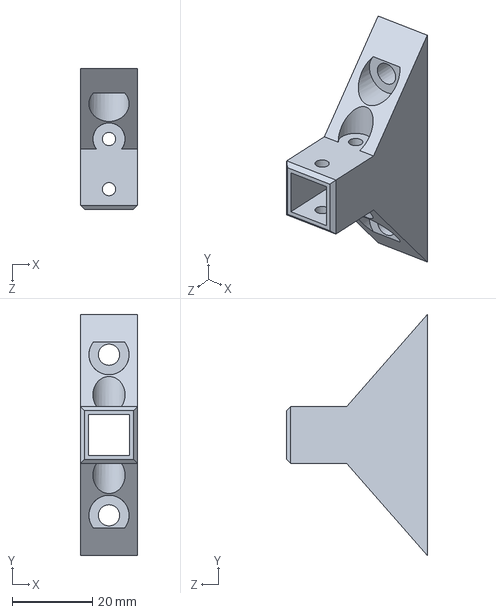
[picture p94: CAD file, 2025-08-03]
Mechanical/Parts/single driver connector outer casing.SLDPRT
14.3 x 60.0 x 35.0 mm
