Ruizhi-Deng/ME350-Project/Mechanical/350 Design Library/Auxiliary wheel.SLDPRT

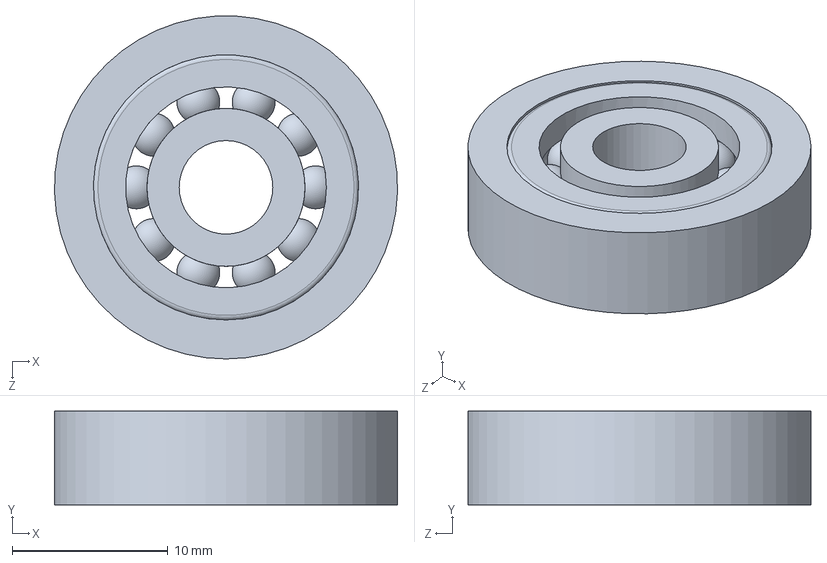
[picture p95: CAD file, 2025-07-29]
Mechanical/350 Design Library/Auxiliary wheel.SLDPRT
22.0 x 6.00 x 22.0 mm
