Ruizhi-Deng/ME350-Project/Mechanical/350 Design Library/PC/PC_short_support.SLDPRT

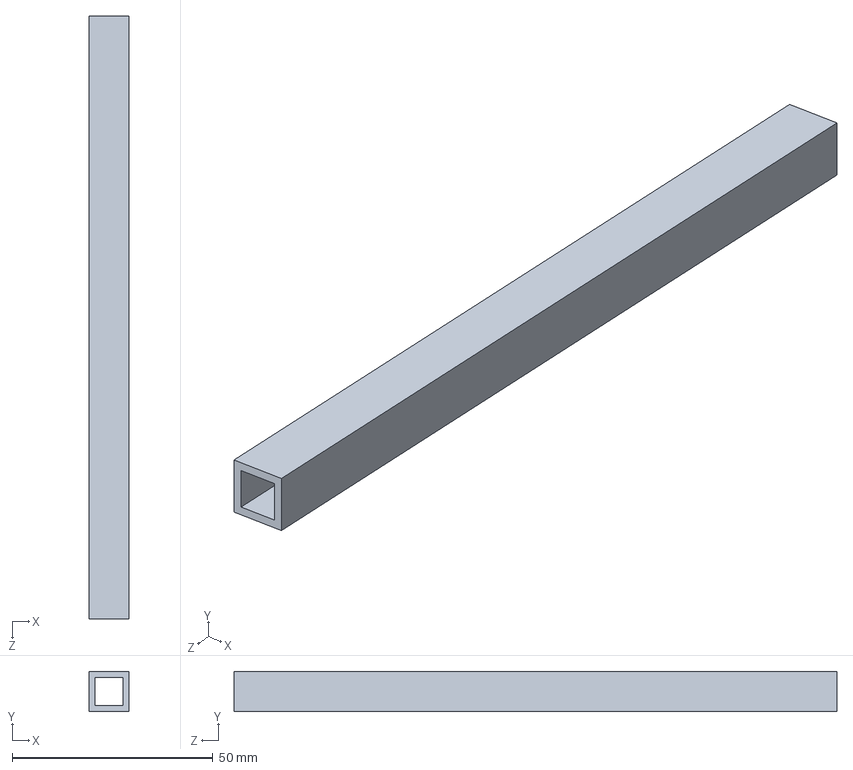
[picture p96: CAD file, 2025-07-11]
Mechanical/350 Design Library/PC/PC_short_support.SLDPRT
10.0 x 10.0 x 150.0 mm
