Ruizhi-Deng/ME350-Project/Mechanical/350 Design Library/树莓派 4 型号 B/2X USB3.0 PORTS, RPi4ModelB.SLDPRT

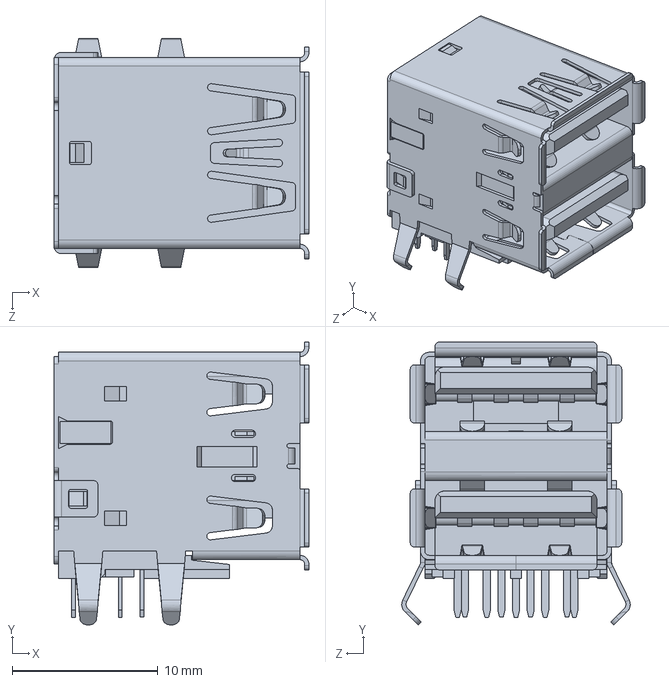
[picture p97: CAD file, 2025-07-08]
Mechanical/350 Design Library/树莓派 4 型号 B/2X USB3.0 PORTS, RPi4ModelB.SLDPRT
17.5 x 19.4 x 15.7 mm
