Ruizhi-Deng/ME350-Project/Mechanical/Control box/L298N Motor Driver.step

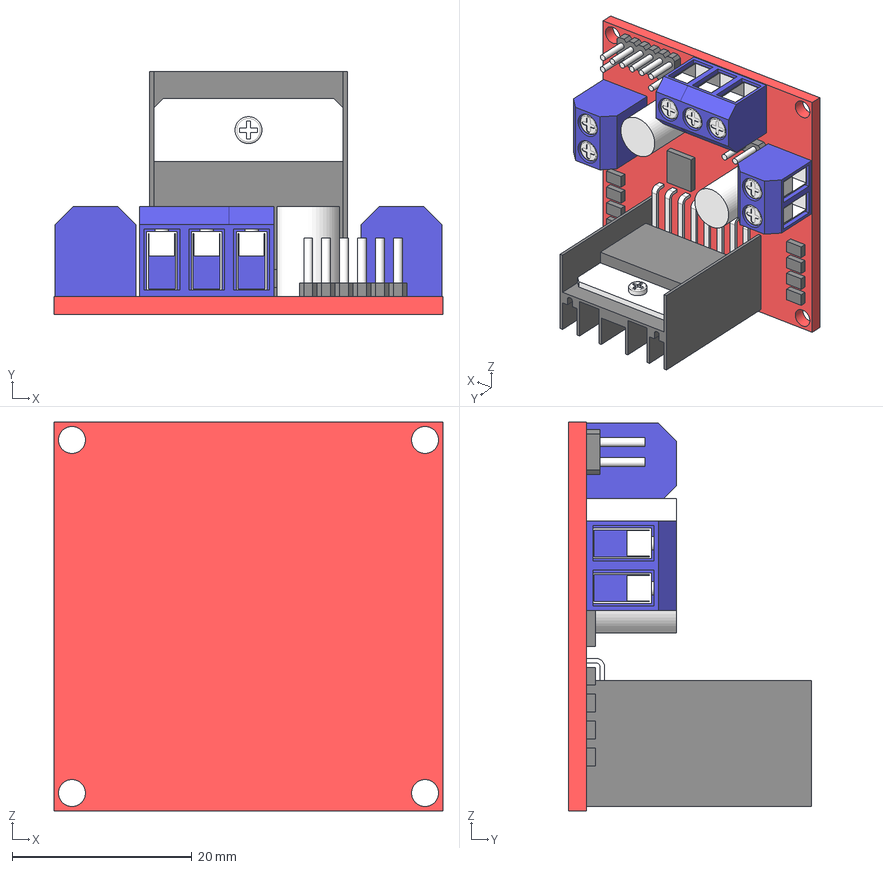
[picture p98: CAD file, 2025-07-21]
Mechanical/Control box/L298N Motor Driver.step
43.3 x 27.0 x 43.3 mm
Pcb
Pengunci x 2
Pengunci 2
