Ruizhi-Deng/ME350-Project/Mechanical/Manufacture/v3/central connector base.3mf

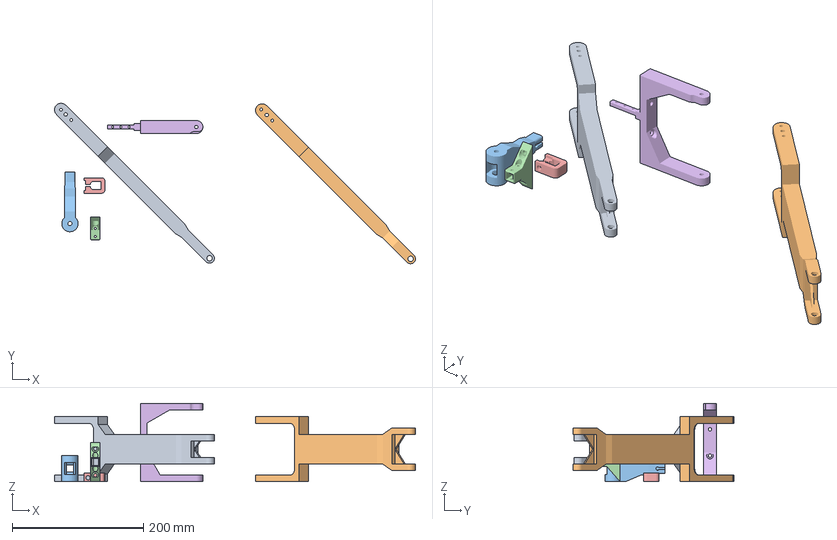
[picture p99: CAD file, 2025-07-15]
Mechanical/Manufacture/v3/central connector base.3mf
550.1 x 244.6 x 119.5 mm
central_inner-driver_inner connector.STL
central_outer-driver_inner connector.STL
frame corner connector.STL
single driver connector outer casing.STL
frame corner connector pc clamp.STL
single driver connector outer.STL
