Ruizhi-Deng/ME350-Project/Mechanical/Parts/single driver connector outer.SLDPRT

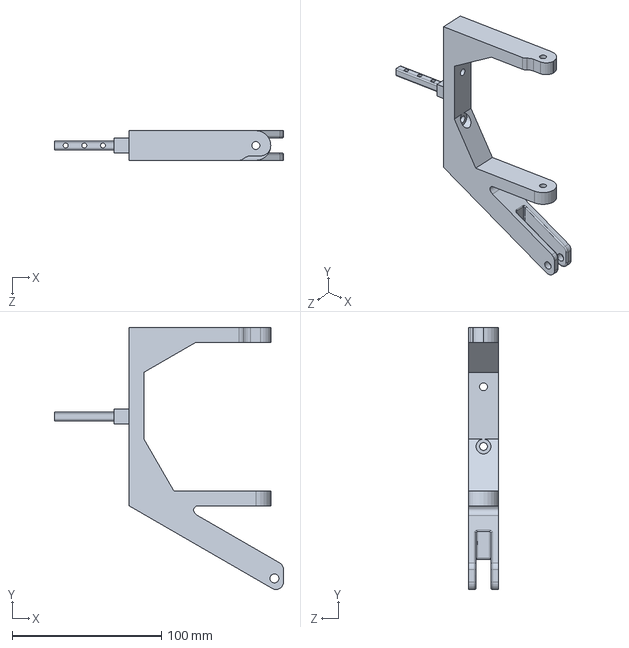
[picture p100: CAD file, 2025-07-29]
Mechanical/Parts/single driver connector outer.SLDPRT
153.5 x 175.6 x 20.0 mm
