Ruizhi-Deng/ME350-Project/Mechanical/350 Design Library/carbon fiber frame.SLDPRT

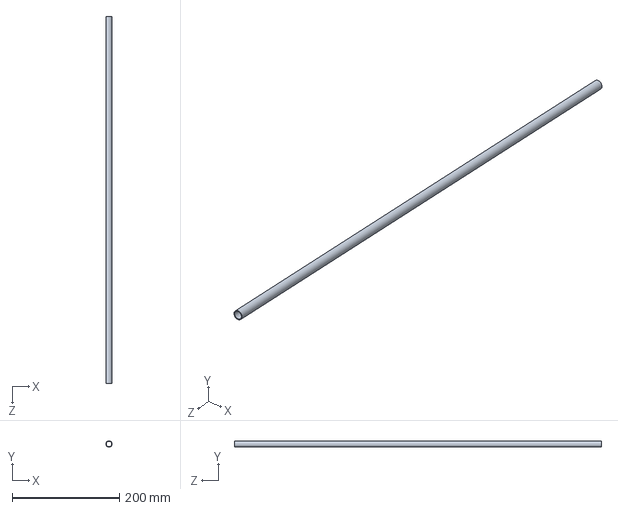
[picture p101: CAD file, 2025-07-15]
Mechanical/350 Design Library/carbon fiber frame.SLDPRT
12.0 x 11.9 x 685.0 mm
