Ruizhi-Deng/ME350-Project/Mechanical/Parts/central connector base.SLDPRT

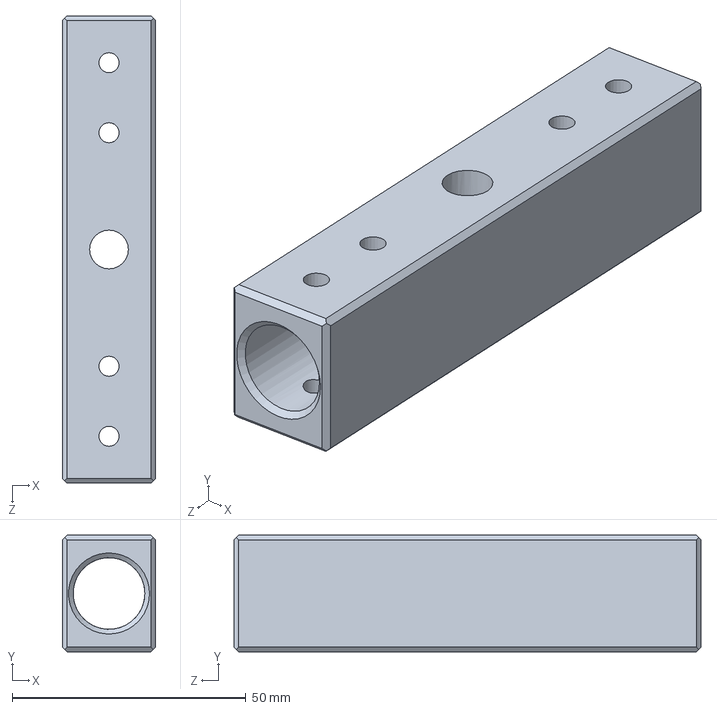
[picture p102: CAD file, 2025-07-15]
Mechanical/Parts/central connector base.SLDPRT
20.0 x 25.0 x 100.0 mm
