Ruizhi-Deng/ME350-Project/Mechanical/350 Design Library/树莓派 4 型号 B/VIA VL805 PCIe USB 3.0 controller, RPi4ModelB.SLDPRT

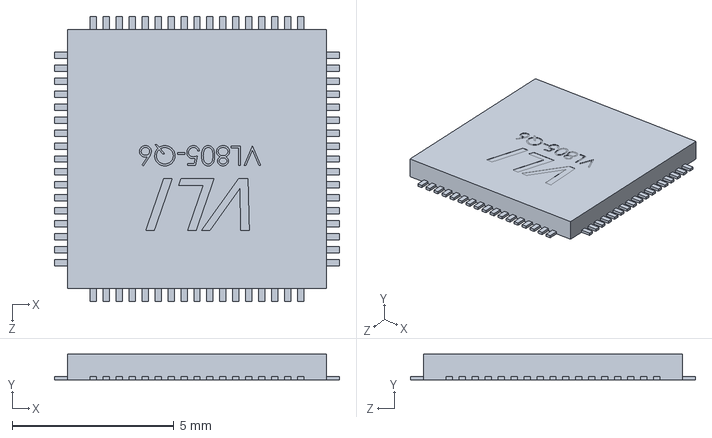
[picture p103: CAD file, 2025-07-08]
Mechanical/350 Design Library/树莓派 4 型号 B/VIA VL805 PCIe USB 3.0 controller, RPi4ModelB.SLDPRT
8.80 x 0.8 x 8.80 mm
