Ruizhi-Deng/ME350-Project/Mechanical/350 Design Library/树莓派 4 型号 B/2.54 mm DUPONT MALE PIN HEADER, IO, 2X20, RPi4ModelB.SLDPRT

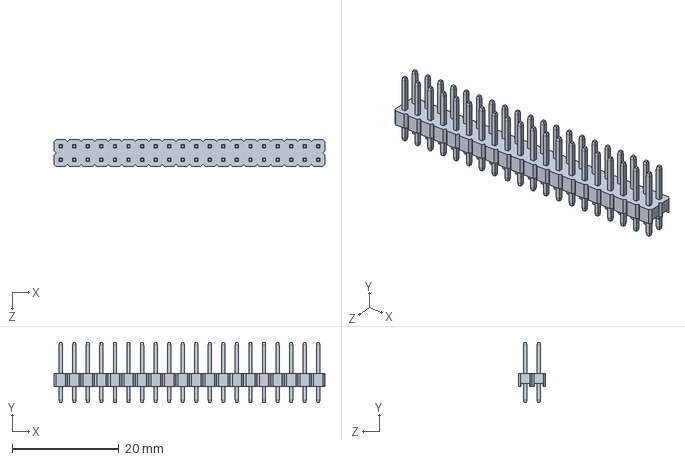
[picture p104: CAD file, 2025-07-08]
Mechanical/350 Design Library/树莓派 4 型号 B/2.54 mm DUPONT MALE PIN HEADER, IO, 2X20, RPi4ModelB.SLDPRT
50.8 x 11.3 x 5.08 mm
