Ruizhi-Deng/ME350-Project/Mechanical/Manufacture/v3/central_inner-driver_inner connector.STL

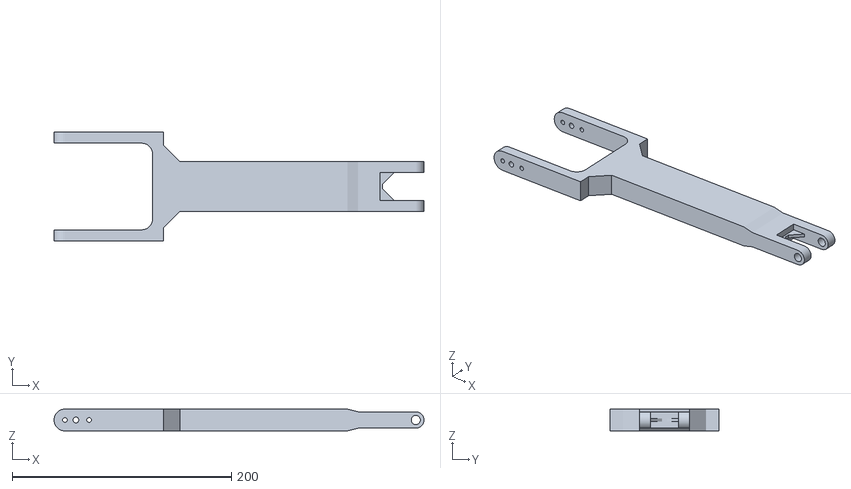
[picture p105: CAD file, 2025-07-15]
Mechanical/Manufacture/v3/central_inner-driver_inner connector.STL
337.5 x 99.0 x 20.0
