Ruizhi-Deng/ME350-Project/Mechanical/Assembly/圆柱.SLDPRT

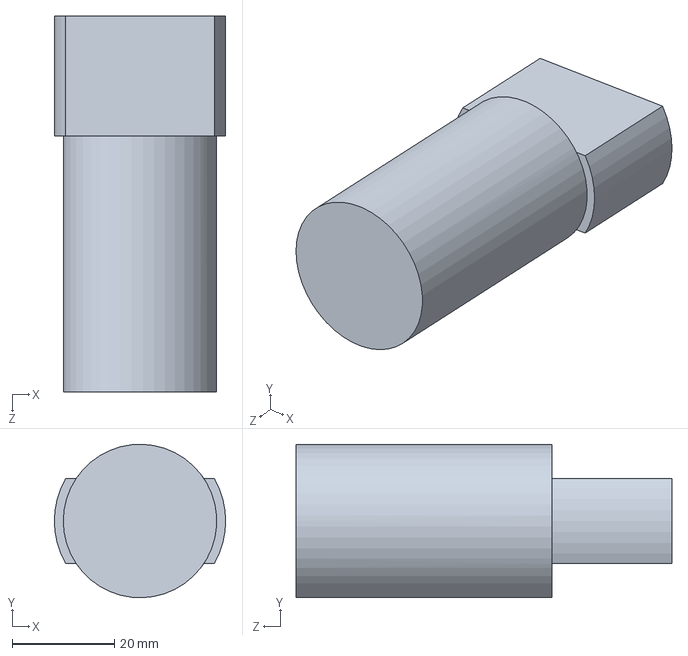
[picture p106: CAD file, 2025-07-29]
Mechanical/Assembly/圆柱.SLDPRT
33.5 x 30.0 x 73.5 mm
