Ruizhi-Deng/ME350-Project/Mechanical/Parts/central_outer-driver_inner connector.SLDPRT

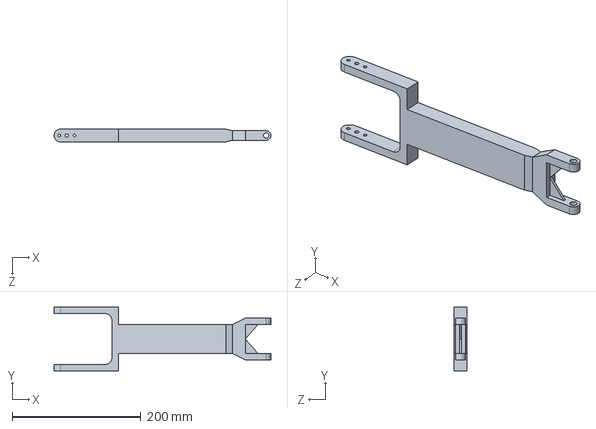
[picture p107: CAD file, 2025-07-14]
Mechanical/Parts/central_outer-driver_inner connector.SLDPRT
337.5 x 99.0 x 20.0 mm
