Ruizhi-Deng/ME350-Project/Mechanical/350 Design Library/树莓派 4 型号 B/Broadcom BCM54213PE Gigabit Ethernet Transceiver, RPi4ModelB.SLDPRT

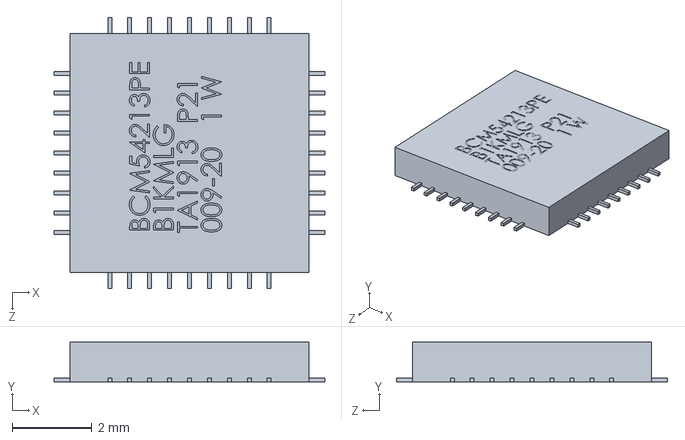
[picture p108: CAD file, 2025-07-08]
Mechanical/350 Design Library/树莓派 4 型号 B/Broadcom BCM54213PE Gigabit Ethernet Transceiver, RPi4ModelB.SLDPRT
6.80 x 1.00 x 6.80 mm
