Ruizhi-Deng/ME350-Project/Mechanical/Manufacture/v3/new frame corner connector base.STL

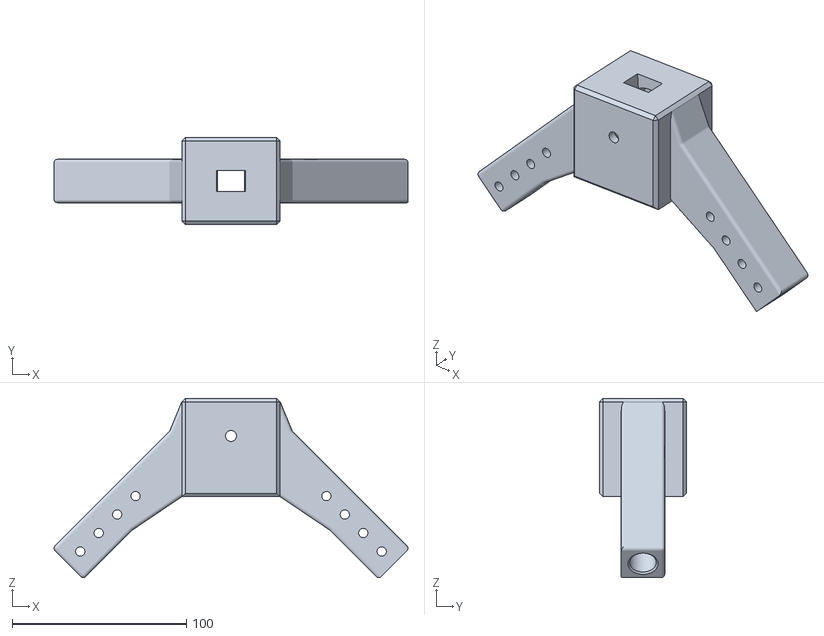
[picture p109: CAD file, 2025-07-15]
Mechanical/Manufacture/v3/new frame corner connector base.STL
203.4 x 50.0 x 103.1
