Ruizhi-Deng/ME350-Project/Mechanical/350 Design Library/树莓派 4 型号 B/Microphone Plug, RPi4ModelB.SLDPRT

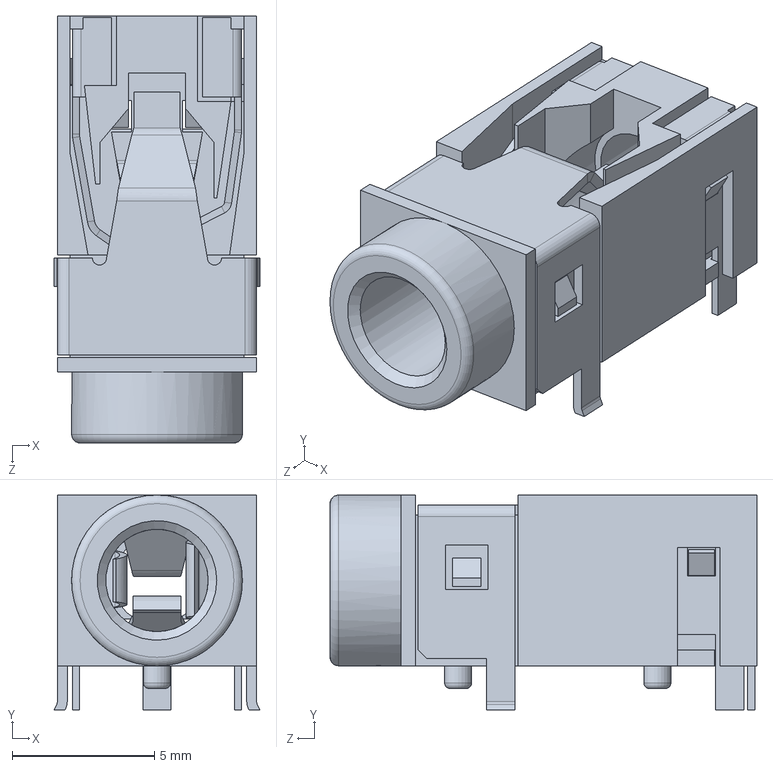
[picture p110: CAD file, 2025-07-08]
Mechanical/350 Design Library/树莓派 4 型号 B/Microphone Plug, RPi4ModelB.SLDPRT
7.23 x 7.55 x 15.0 mm
