Ruizhi-Deng/ME350-Project/Mechanical/Parts/frame corner connector.SLDPRT

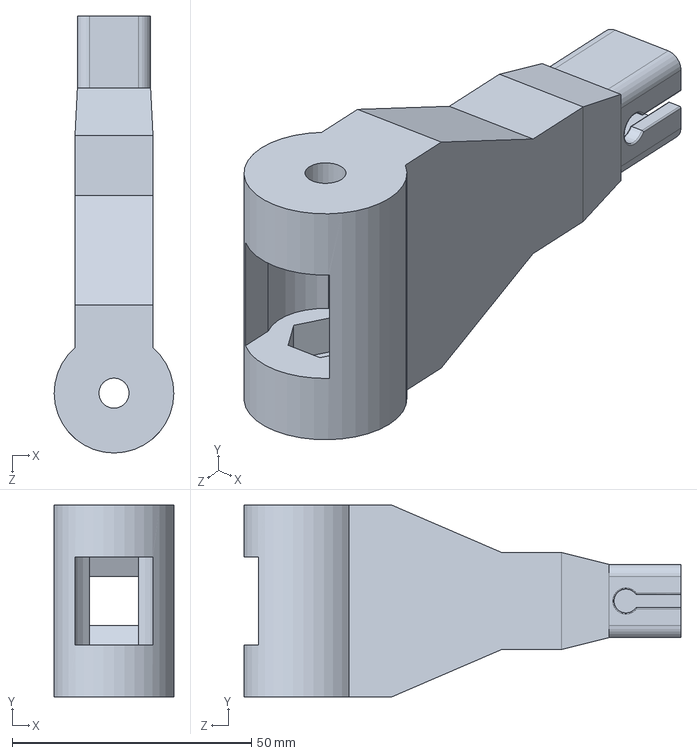
[picture p111: CAD file, 2025-07-14]
Mechanical/Parts/frame corner connector.SLDPRT
25.0 x 40.0 x 91.3 mm
