Ruizhi-Deng/ME350-Project/Mechanical/350 Design Library/树莓派 4 型号 B/91D77 D9WHV 778K, 4 GB LPDDR4 SDRAM, RPi4ModelB.SLDPRT

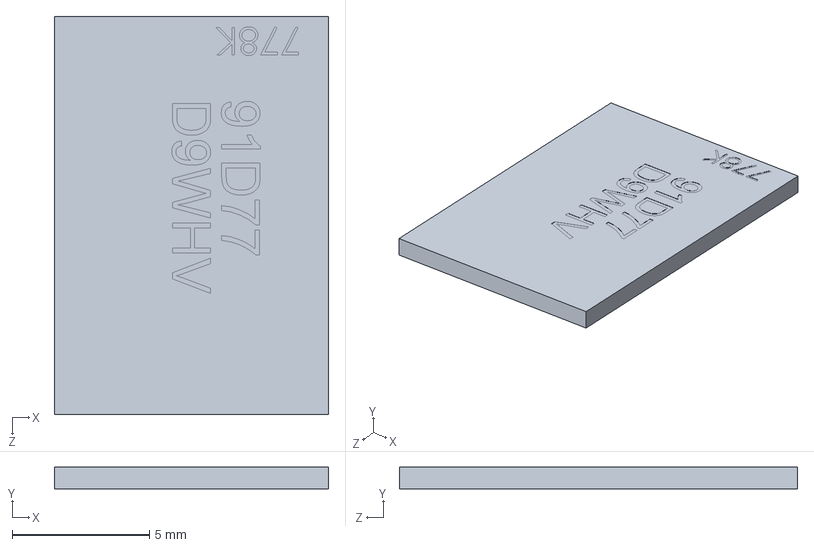
[picture p112: CAD file, 2025-07-08]
Mechanical/350 Design Library/树莓派 4 型号 B/91D77 D9WHV 778K, 4 GB LPDDR4 SDRAM, RPi4ModelB.SLDPRT
10.0 x 0.8 x 14.5 mm
