Ruizhi-Deng/ME350-Project/Mechanical/Parts/frame corner connector pc clamp.SLDPRT

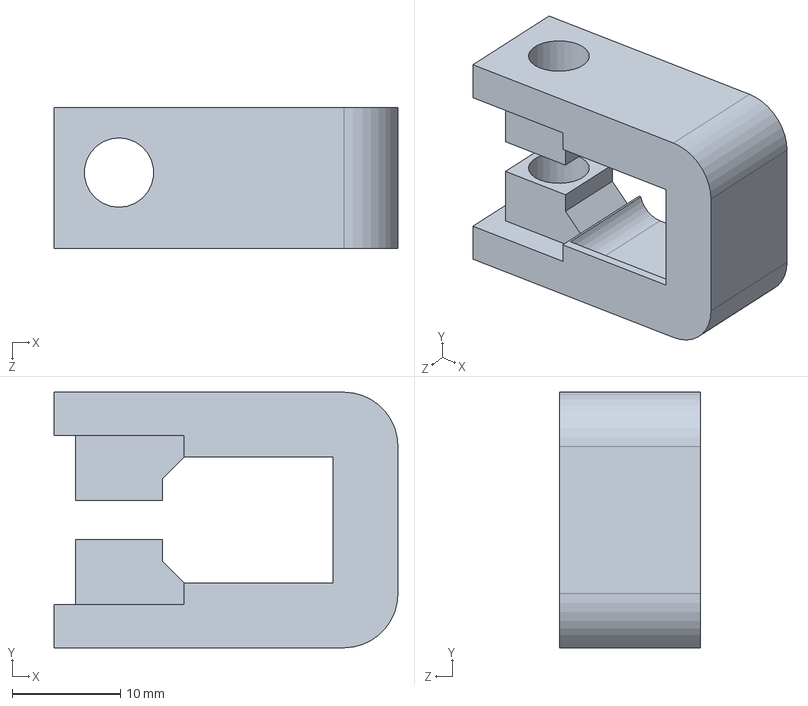
[picture p113: CAD file, 2025-07-11]
Mechanical/Parts/frame corner connector pc clamp.SLDPRT
31.8 x 23.6 x 13.0 mm
