Ruizhi-Deng/ME350-Project/Mechanical/350 Design Library/树莓派 4 型号 B/2X USB2.0 PORTS, RPi4ModelB.SLDPRT

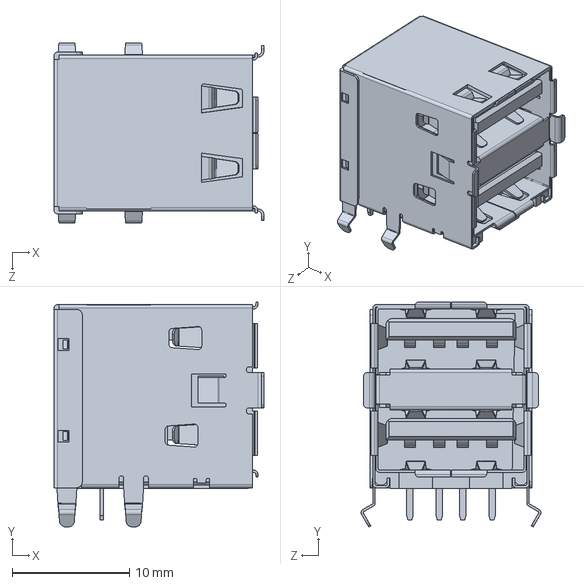
[picture p114: CAD file, 2025-07-08]
Mechanical/350 Design Library/树莓派 4 型号 B/2X USB2.0 PORTS, RPi4ModelB.SLDPRT
17.9 x 19.2 x 15.3 mm
