Ruizhi-Deng/ME350-Project/Mechanical/350 Design Library/树莓派 4 型号 B/2.54 mm DUPONT MALE PIN HEADER, POE, 2X2, RPi4ModelB.SLDPRT

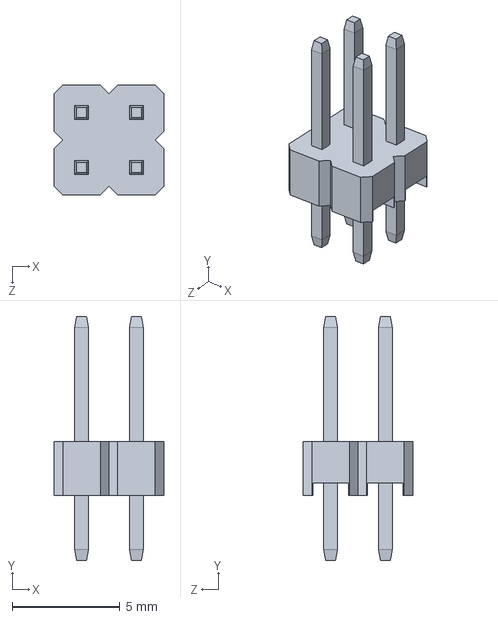
[picture p115: CAD file, 2025-07-08]
Mechanical/350 Design Library/树莓派 4 型号 B/2.54 mm DUPONT MALE PIN HEADER, POE, 2X2, RPi4ModelB.SLDPRT
5.08 x 11.3 x 5.08 mm
