Ruizhi-Deng/ME350-Project/Mechanical/350 Design Library/树莓派 4 型号 B/Female Micro HDMI Connector, RPi4ModelB.SLDPRT

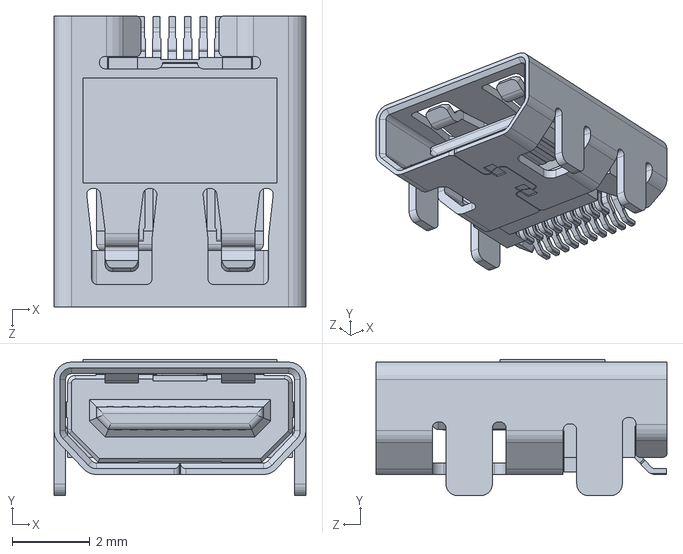
[picture p116: CAD file, 2025-07-08]
Mechanical/350 Design Library/树莓派 4 型号 B/Female Micro HDMI Connector, RPi4ModelB.SLDPRT
6.50 x 3.52 x 7.50 mm
