Ruizhi-Deng/ME350-Project/Mechanical/350 Design Library/树莓派 4 型号 B/Female USB Type C Connector, RPi4ModelB.SLDPRT

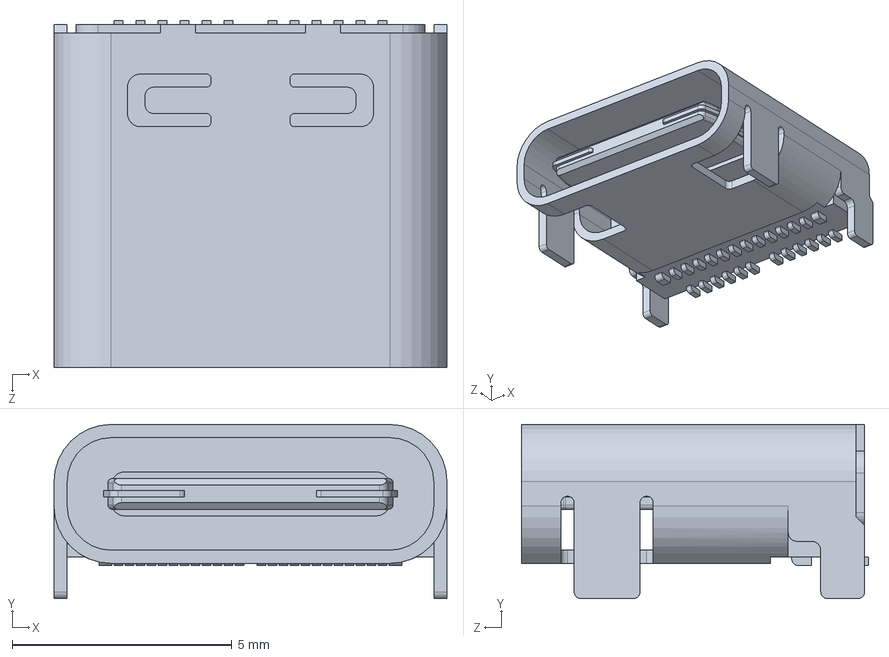
[picture p117: CAD file, 2025-07-08]
Mechanical/350 Design Library/树莓派 4 型号 B/Female USB Type C Connector, RPi4ModelB.SLDPRT
8.94 x 3.96 x 7.90 mm
