Ruizhi-Deng/ME350-Project/Mechanical/350 Design Library/树莓派 4 型号 B/SD Card Slot, RPi4ModelB.SLDPRT

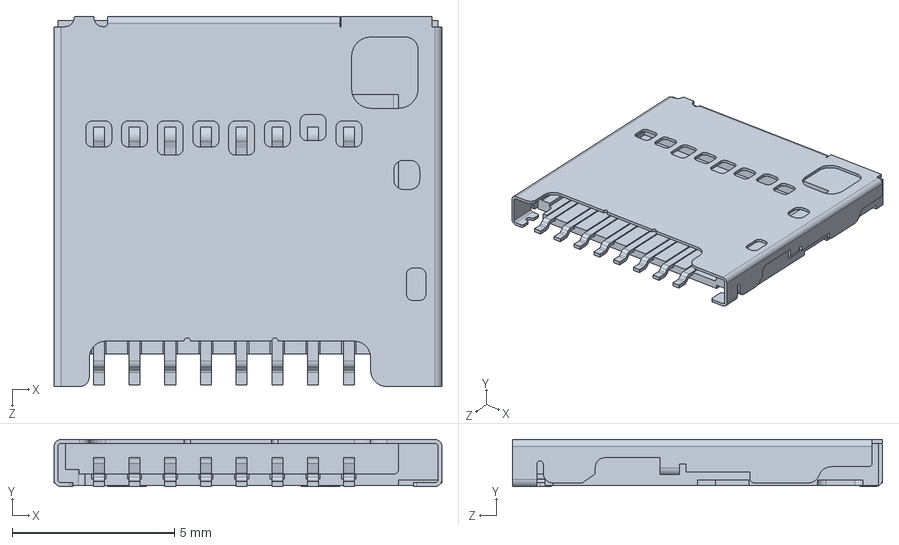
[picture p118: CAD file, 2025-07-08]
Mechanical/350 Design Library/树莓派 4 型号 B/SD Card Slot, RPi4ModelB.SLDPRT
11.9 x 1.45 x 11.4 mm
