Ruizhi-Deng/ME350-Project/Mechanical/350 Design Library/树莓派 4 型号 B/MxL7704 Universal PMIC, RPi4ModelB.SLDPRT

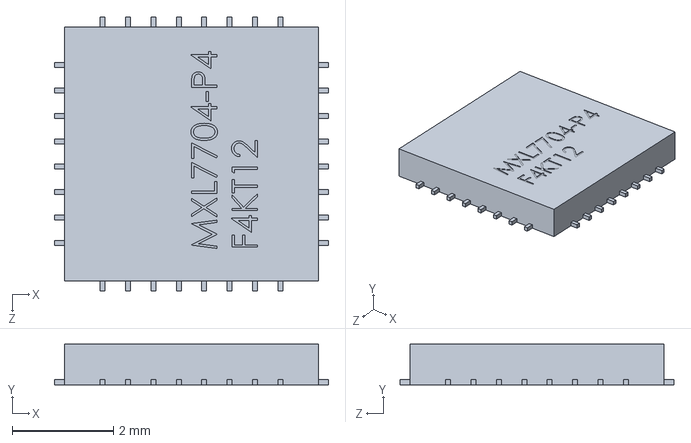
[picture p119: CAD file, 2025-07-08]
Mechanical/350 Design Library/树莓派 4 型号 B/MxL7704 Universal PMIC, RPi4ModelB.SLDPRT
5.40 x 0.8 x 5.40 mm
