Ruizhi-Deng/ME350-Project/Mechanical/350 Design Library/树莓派 4 型号 B/PCB, RPi4ModelB.SLDPRT

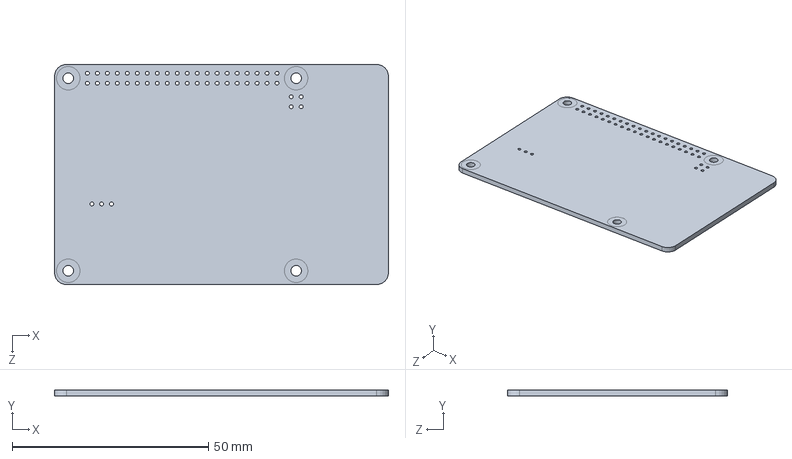
[picture p120: CAD file, 2025-07-08]
Mechanical/350 Design Library/树莓派 4 型号 B/PCB, RPi4ModelB.SLDPRT
85.0 x 1.60 x 56.0 mm
