Ruizhi-Deng/ME350-Project/Mechanical/350 Design Library/树莓派 4 型号 B/Cypress CYW43455 Wireless Module Cover, RPi4ModelB.SLDPRT

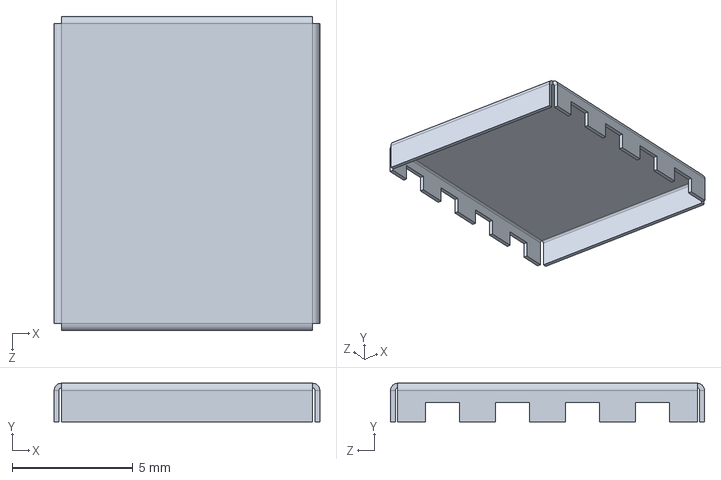
[picture p121: CAD file, 2025-07-08]
Mechanical/350 Design Library/树莓派 4 型号 B/Cypress CYW43455 Wireless Module Cover, RPi4ModelB.SLDPRT
11.0 x 1.60 x 13.0 mm
