Ruizhi-Deng/ME350-Project/Mechanical/350 Design Library/树莓派 4 型号 B/Broadcom BCM2711B0 CPU, RPi4ModelB.SLDPRT

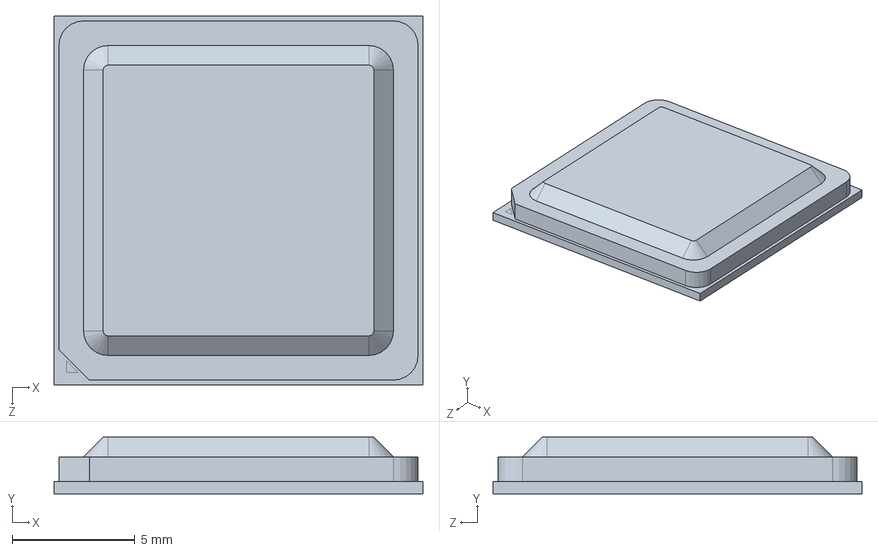
[picture p122: CAD file, 2025-07-08]
Mechanical/350 Design Library/树莓派 4 型号 B/Broadcom BCM2711B0 CPU, RPi4ModelB.SLDPRT
15.0 x 2.30 x 15.0 mm
