Ruizhi-Deng/ME350-Project/(list of files, cad)

Other CAD files:
Mechanical/Control box/stl_v3/control_board.STL
Mechanical/Control box/stl_v3/power_board.STL
Mechanical/synthesis.SLDPRT
Mechanical/Manufacture/v3/single driver connector outer casing.STL
Mechanical/Parts/12mm to 15mm.SLDPRT
Mechanical/Parts/central_inner-driver_inner connector.SLDPRT
Mechanical/350 Design Library/树莓派 4 型号 B/Camera Connector, RPi4ModelB.SLDPRT
Mechanical/Manufacture/v3/single driver supportor.STL
Mechanical/Parts/new frame corner connector base.SLDPRT
Mechanical/Manufacture/v3/central_outer-driver_inner connector.STL
Mechanical/Manufacture/v3/frame corner connector.STL
Mechanical/Manufacture/v3/frame corner connector pc clamp.STL
Mechanical/350 Design Library/Easy-assembly screw/Easy-assemble screw.SLDASM
Mechanical/350 Design Library/Easy-assembly screw/handle.SLDPRT
Mechanical/350 Design Library/Easy-assembly screw/nut.SLDPRT
Mechanical/350 Design Library/Easy-assembly screw/shaft.SLDPRT
Mechanical/350 Design Library/Easy-assembly screw/spacer.SLDPRT
Mechanical/350 Design Library/Standard Parts/Bearings/3-6 Series Bearing-SJTUVEX.SLDPRT
Mechanical/350 Design Library/Standard Parts/Bearings/3-Bearings with Threaded Shaft-SJTUVEX.SLDPRT
Mechanical/350 Design Library/Standard Parts/Bearings/3-Bushing-SJTUVEX.SLDPRT
Mechanical/350 Design Library/Standard Parts/Bearings/3-F6 Series Bearing-SJTUVEX.SLDPRT
Mechanical/350 Design Library/Standard Parts/Bearings/3-Flanged Bushing-SJTUVEX.SLDPRT
Mechanical/350 Design Library/Standard Parts/Bearings/3-Joint Bearing_Joint-SJTUVEX.SLDPRT
Mechanical/350 Design Library/Standard Parts/Bearings/3-SYKZ Flanged Bushing-SJTUVEX.SLDPRT
Mechanical/350 Design Library/Standard Parts/Bearings/3-SYSD Flanged Bushing-SJTUVEX.SLDPRT
Mechanical/350 Design Library/Standard Parts/Bearings/3-Trust Bearings-SJTUVEX.SLDPRT
Mechanical/350 Design Library/Standard Parts/Bearings/4-KA030XPO Bearing-SJTUVEX.sldprt
Mechanical/350 Design Library/Standard Parts/Bearings/6-PTFE Bearing-SJTUVEX.SLDPRT
Mechanical/350 Design Library/Standard Parts/Bearings/SA_TK Bearing/5-SA_TK Ball-SJTUVEX.sldprt
Mechanical/350 Design Library/Standard Parts/Bearings/SA_TK Bearing/5-SA_TK Rod End Bearings-SJTUVEX.sldasm
Mechanical/350 Design Library/Standard Parts/Bearings/SA_TK Bearing/5-SA_TK Rod-SJTUVEX.sldprt
Mechanical/350 Design Library/Standard Parts/Bearings/SI_TK_Bearing/5-SI_TK Ball-SJTUVEX.sldprt
Mechanical/350 Design Library/Standard Parts/Bearings/SI_TK_Bearing/5-SI_TK Rod End Bearings-SJTUVEX.sldasm
Mechanical/350 Design Library/Standard Parts/Bearings/SI_TK_Bearing/5-SI_TK Rod-SJTUVEX.sldprt
Mechanical/350 Design Library/Standard Parts/Motion/7-Gear design by Module-SJTUVEX.SLDPRT
Mechanical/350 Design Library/Standard Parts/Motion/7-Gear-SJTUVEX.SLDPRT
Mechanical/350 Design Library/Standard Parts/Motion/7-Gear_rev1-SJTUVEX.SLDPRT
Mechanical/350 Design Library/Standard Parts/Motion/7-Gear_rev2-SJTUVEX.SLDPRT
Mechanical/350 Design Library/Standard Parts/Motion/7-HTD Pulley Wheel-SJTUVEX.SLDPRT
Mechanical/350 Design Library/Standard Parts/Nuts/3-Flat Head Knurl Pull Rivet Nuts-SJTUVEX.SLDPRT
Mechanical/350 Design Library/Standard Parts/Nuts/3-K Shape Hexagon Nuts-SJTUVEX.SLDPRT
Mechanical/350 Design Library/Standard Parts/Nuts/3-Nylon Hexagon Nuts-SJTUVEX.SLDPRT
Mechanical/350 Design Library/Standard Parts/Nuts/3-Plastic Hexagon Nuts-SJTUVEX.SLDPRT
Mechanical/350 Design Library/Standard Parts/Nuts/3-Pressing rivet Nuts-SJTUVEX.SLDPRT
Mechanical/350 Design Library/Standard Parts/Nuts/3-Regular Hexagon Nuts-SJTUVEX.SLDPRT
Mechanical/350 Design Library/Standard Parts/Nuts/3-Square Shape Nuts-SJTUVEX.SLDPRT
Mechanical/350 Design Library/Standard Parts/Nuts/3-Thin Hex Nuts-SJTUVEX.SLDPRT
Mechanical/350 Design Library/Standard Parts/Nuts/4-K Shape Hexagon Nuts-SJTUVEX.SLDPRT
Mechanical/350 Design Library/Standard Parts/Nuts/4-Nylon Hexagon Nuts-SJTUVEX.SLDPRT
Mechanical/350 Design Library/Standard Parts/Nuts/5-0006 Cold Pressing Nuts-SJTUVEX.SLDPRT
Mechanical/350 Design Library/Standard Parts/Nuts/5-001 002 Cold Pressing Nuts-SJTUVEX.SLDPRT
Mechanical/350 Design Library/Standard Parts/Nuts/5-071 072 073 Cold Pressing Nuts-SJTUVEX.SLDPRT
Mechanical/350 Design Library/Standard Parts/Nuts/5-Slot Expension Nuts-SJTUVEX.SLDPRT
Mechanical/350 Design Library/Standard Parts/Rings/3-Clamping Shaft Collar-SJTUVEX.SLDPRT
Mechanical/350 Design Library/Standard Parts/Rings/3-Keyway Cotter-SJTUVEX.SLDPRT
Mechanical/350 Design Library/Standard Parts/Rings/3-Shaft Circlip Rings-SJTUVEX.SLDPRT
Mechanical/350 Design Library/Standard Parts/Rings/3-Thrust Shaft Collar-SJTUVEX.SLDPRT
Mechanical/350 Design Library/Standard Parts/Rivet/3-Aluminum Countersink Rivet-SJTUVEX.SLDPRT
Mechanical/350 Design Library/Standard Parts/Rivet/3-Aluminum Pop Rivet-SJTUVEX.SLDPRT
Mechanical/350 Design Library/Standard Parts/Screws/3-Cap Head Hexagon Screws-SJTUVEX.SLDPRT
Mechanical/350 Design Library/Standard Parts/Screws/3-Cap Head Shoulder Hexagon Screws-SJTUVEX.SLDPRT
Mechanical/350 Design Library/Standard Parts/Screws/3-Eye Screws-SJTUVEX.SLDPRT
Mechanical/350 Design Library/Standard Parts/Screws/3-Flat Head Hexagon Screws-SJTUVEX.SLDPRT
Mechanical/350 Design Library/Standard Parts/Screws/3-Hex Head Screws-SJTUVEX.SLDPRT
Mechanical/350 Design Library/Standard Parts/Screws/3-Plastic Philip's Round Head Screws-SJTUVEX.SLDPRT
Mechanical/350 Design Library/Standard Parts/Screws/3-Round Head Hexagon Screws-SJTUVEX.SLDPRT
Mechanical/350 Design Library/Standard Parts/Screws/3-Set Screws-SJTUVEX.SLDPRT
Mechanical/350 Design Library/Standard Parts/Screws/3-Threaded Stud Knobs-SJTUVEX.SLDPRT
Mechanical/350 Design Library/Standard Parts/Screws/4-Cap Head Hexagon Screws-SJTUVEX.SLDPRT
Mechanical/350 Design Library/Standard Parts/Screws/4-Cap Head Shoulder Hexagon Screws-SJTUVEX.SLDPRT
Mechanical/350 Design Library/Standard Parts/Screws/4-Round Head Hexagon Screws-SJTUVEX.SLDPRT
Mechanical/350 Design Library/Standard Parts/Screws/4-Set Screws-SJTUVEX.SLDPRT
Mechanical/350 Design Library/Standard Parts/Servo/PWM Servo/60kg Servo/asm-DS5160.SLDASM
Mechanical/350 Design Library/Standard Parts/Servo/PWM Servo/60kg Servo/asm-DS5160.STEP
Mechanical/350 Design Library/Standard Parts/Servo/PWM Servo/60kg Servo/asm-RDS5160.SLDASM
Mechanical/350 Design Library/Standard Parts/Servo/PWM Servo/60kg Servo/asm-RDS5160.STEP
Mechanical/350 Design Library/Standard Parts/Servo/PWM Servo/Double Axis/GB_CROSS_SCREWS_TYPE1 M3X5-5 Z type-N.sldprt
Mechanical/350 Design Library/Standard Parts/Servo/PWM Servo/Double Axis/GB_CROSS_SCREWS_TYPE130 ST2.2X6.5 H C-N.sldprt
Mechanical/350 Design Library/Standard Parts/Servo/PWM Servo/Double Axis/侧面宽u.SLDASM
Mechanical/350 Design Library/Standard Parts/Servo/PWM Servo/Double Axis/侧面支架 New.SLDPRT
Mechanical/350 Design Library/Standard Parts/Servo/PWM Servo/Double Axis/侧面支架.SLDPRT
Mechanical/350 Design Library/Standard Parts/Servo/PWM Servo/Double Axis/十字u2舵机.SLDASM
Mechanical/350 Design Library/Standard Parts/Servo/PWM Servo/Double Axis/十字u2舵机.STEP
Mechanical/350 Design Library/Standard Parts/Servo/PWM Servo/Double Axis/十字大U支架.SLDPRT
Mechanical/350 Design Library/Standard Parts/Servo/PWM Servo/Double Axis/双轴舵机.SLDPRT
Mechanical/350 Design Library/Standard Parts/Servo/PWM Servo/Double Axis/双轴舵机.STEP
Mechanical/350 Design Library/Standard Parts/Servo/PWM Servo/Double Axis/塑料主舵盘.SLDPRT
Mechanical/350 Design Library/Standard Parts/Servo/PWM Servo/Double Axis/塑料从舵盘.SLDPRT
Mechanical/350 Design Library/Standard Parts/Servo/PWM Servo/Double Axis/宽U支架.SLDPRT
Mechanical/350 Design Library/Standard Parts/Servo/PWM Servo/Double Axis/宽窄u.SLDASM
Mechanical/350 Design Library/Standard Parts/Servo/PWM Servo/Double Axis/宽窄u.STEP
Mechanical/350 Design Library/Standard Parts/Servo/PWM Servo/Double Axis/小U连接件.SLDPRT
Mechanical/350 Design Library/Standard Parts/Servo/PWM Servo/Double Axis/小u连接2舵机.SLDASM
Mechanical/350 Design Library/Standard Parts/Servo/PWM Servo/Double Axis/小u连接2舵机.STEP
Mechanical/350 Design Library/Standard Parts/Servo/PWM Servo/Double Axis/窄U支架.SLDPRT
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
