Ruizhi-Deng/ME350-Project/(commit log)

2025-05-21 init: first commit
    [11多功能支架组合.SLDASM, 12固定杯式轴承.SLDASM, 13固定K20舵机1.SLDASM, 14固定K20舵机2.SLDASM, 15固定舵盘1.SLDASM, 16固定长u支架.SLDASM, 17固定舵盘2.SLDASM, 2个舵机连接件（短U）.SLDASM]
2025-06-20 update: single driver
    [Double Output Axis JGY370.SLDPRT, Double Output Axis JGY370.STEP, reference.SLDPRT, single driver connector.SLDPRT, single driver supportor.SLDPRT, single_driver.SLDASM, support.SLDPRT, wheel.SLDPRT]
2025-06-21 update: driver set
    [Assembly.SLDASM, PC.SLDPRT, central connector base.SLDPRT, central connector inner.SLDPRT, central connector outer.SLDPRT, reference.SLDPRT, single driver connector inner.SLDPRT, single driver connector outer.SLDPRT]
2025-07-05 update: stable v1
    [Assembly.SLDASM, PC.SLDPRT, central connector base.SLDPRT, central connector inner.SLDPRT, central connector outer.SLDPRT, frame corner connector base.SLDPRT, frame corner connector pc clamp.SLDPRT, frame corner connector.SLDPRT]
2025-07-08 release: v1 patch
    [Assembly.SLDASM, PC_frame.SLDPRT, PC_long_support.SLDPRT, PC_short_support.SLDPRT, central connector base.3mf, central connector base.STL, central connector inner.STL, central connector outer.STL]
2025-07-08 update: strawberry pi 4b model
    [2.54 mm DUPONT MALE PIN HEADER, IO, 2X20, RPi4ModelB.SLDPRT, 2.54 mm DUPONT MALE PIN HEADER, IO, 2X40, RPi4ModelB.SLDPRT, 2.54 mm DUPONT MALE PIN HEADER, POE, 2X2, RPi4ModelB.SLDPRT, 2X USB2.0 PORTS, RPi4ModelB.SLDPRT, 2X USB3.0 PORTS, RPi4ModelB.SLDPRT, 91D77 D9WHV 778K, 4 GB LPDDR4 SDRAM, RPi4ModelB.SLDPRT, Broadcom BCM2711B0 CPU, RPi4ModelB.SLDPRT, Broadcom BCM54213PE Gigabit Ethernet Transcei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]
2025-07-11 update: easy-assembly screw
    [3-Aluminum Pop Rivet-SJTUVEX.SLDPRT, 3-K Shape Hexagon Nuts-SJTUVEX.SLDPRT, 3-Nylon Hexagon Nuts-SJTUVEX.SLDPRT, 3-Plain Washers-SJTUVEX.SLDPRT, 3-Square Shape Nuts-SJTUVEX.SLDPRT, Assembly.SLDASM, Double Output Axis JGY370.SLDPRT, Easy-assemble screw.SLDASM]
2025-07-11 update: easy-assembly screw on final assembly
    [Assembly.SLDASM, Easy-assemble screw.SLDASM]
2025-07-11 update: rendered pics
    [Assembly.SLDASM, Easy-assemble screw.SLDASM, PC_frame.SLDPRT, central connector base.SLDPRT, reference new.SLDPRT]
2025-07-12 update: v1
    [Assembly.SLDASM]
2025-07-14 release: v2
    [11多功能支架组合.SLDASM, 12mm to 15mm.SLDPRT, 12固定杯式轴承.SLDASM, 13固定K20舵机1.SLDASM, 14固定K20舵机2.SLDASM, 15固定舵盘1.SLDASM, 16固定长u支架.SLDASM, 17固定舵盘2.SLDASM]
2025-07-15 update: v2 manufacture files
    [11多功能支架组合.SLDASM, 12mm to 15mm.STL, 12固定杯式轴承.SLDASM, 13固定K20舵机1.SLDASM, 14固定K20舵机2.SLDASM, 15固定舵盘1.SLDASM, 16固定长u支架.SLDASM, 17固定舵盘2.SLDASM]
2025-07-15 add control box
    [Assembly.SLDASM, L298N Motor Driver.step, control_board.SLDPRT, control_board.STL, power_board.SLDPRT, power_board.STL]
2025-07-21 update: manual merge improveStability
    [Assembly.SLDASM, control_board.SLDPRT, drive set central inner.SLDASM, drive set central outer.SLDASM, new frame.SLDASM, power_board.SLDPRT, single driver connector outer.SLDPRT]
2025-07-21 update: additional files
    [control_board.STL, power_board.STL, single driver connector outer_v2.1.STL, single driver connector outer_v3.STL]
2025-07-22 fix: mating issues; final product
    [3-Cap Head Hexagon Screws-SJTUVEX.SLDPRT, Assembly.SLDASM, Easy-assemble screw.SLDASM, control_board.SLDPRT, drive set central inner.SLDASM, drive set central outer.SLDASM, frame corner connector.SLDASM, single driver connector outer.SLDPRT]
2025-07-29 update: report figures
    [12mm to 15mm.STL, 3-Nylon Spacers-SJTUVEX.SLDPRT, 3-Shaft Circlip Rings-SJTUVEX.SLDPRT, Assembly.SLDASM, Auxiliary wheel shaft.SLDPRT, Auxiliary wheel.SLDPRT, Easy-assemble screw.SLDASM, central connector base.3mf]
2025-08-03 update: invoice
    [Assembly.SLDASM, Double Output Axis JGY370.SLDPRT, drive set central inner.SLDASM, drive set central outer.SLDASM, frame corner connector.SLDASM, new frame.SLDASM, reference new.SLDPRT, single driver connector outer casing.SLDPRT]
2025-08-08 update: final report
    [Al frame.SLDPRT, Assembly.SLDASM, drive set central inner.SLDASM, drive set central outer.SLDASM]
